scrameta/mega_videl/README.md

# mega_videl

- 1GB 32-bit wide DDR3 ram running at 400MHz
- Cyclone V GX FPGA
- DVI + audio output up to 300MHz (4K30)
- Falcon audio intercept + modify
- High speed link to future expansion (Plan: System ram board)
- PCIe 1x
- USB2
- Ethernet
