scrameta/mega_videl/board/kicad/mega_videl/mega_videl.kicad_pcb

## KiCad design board/kicad/mega_videl/mega_videl.kicad_pcb (2026-10-27)

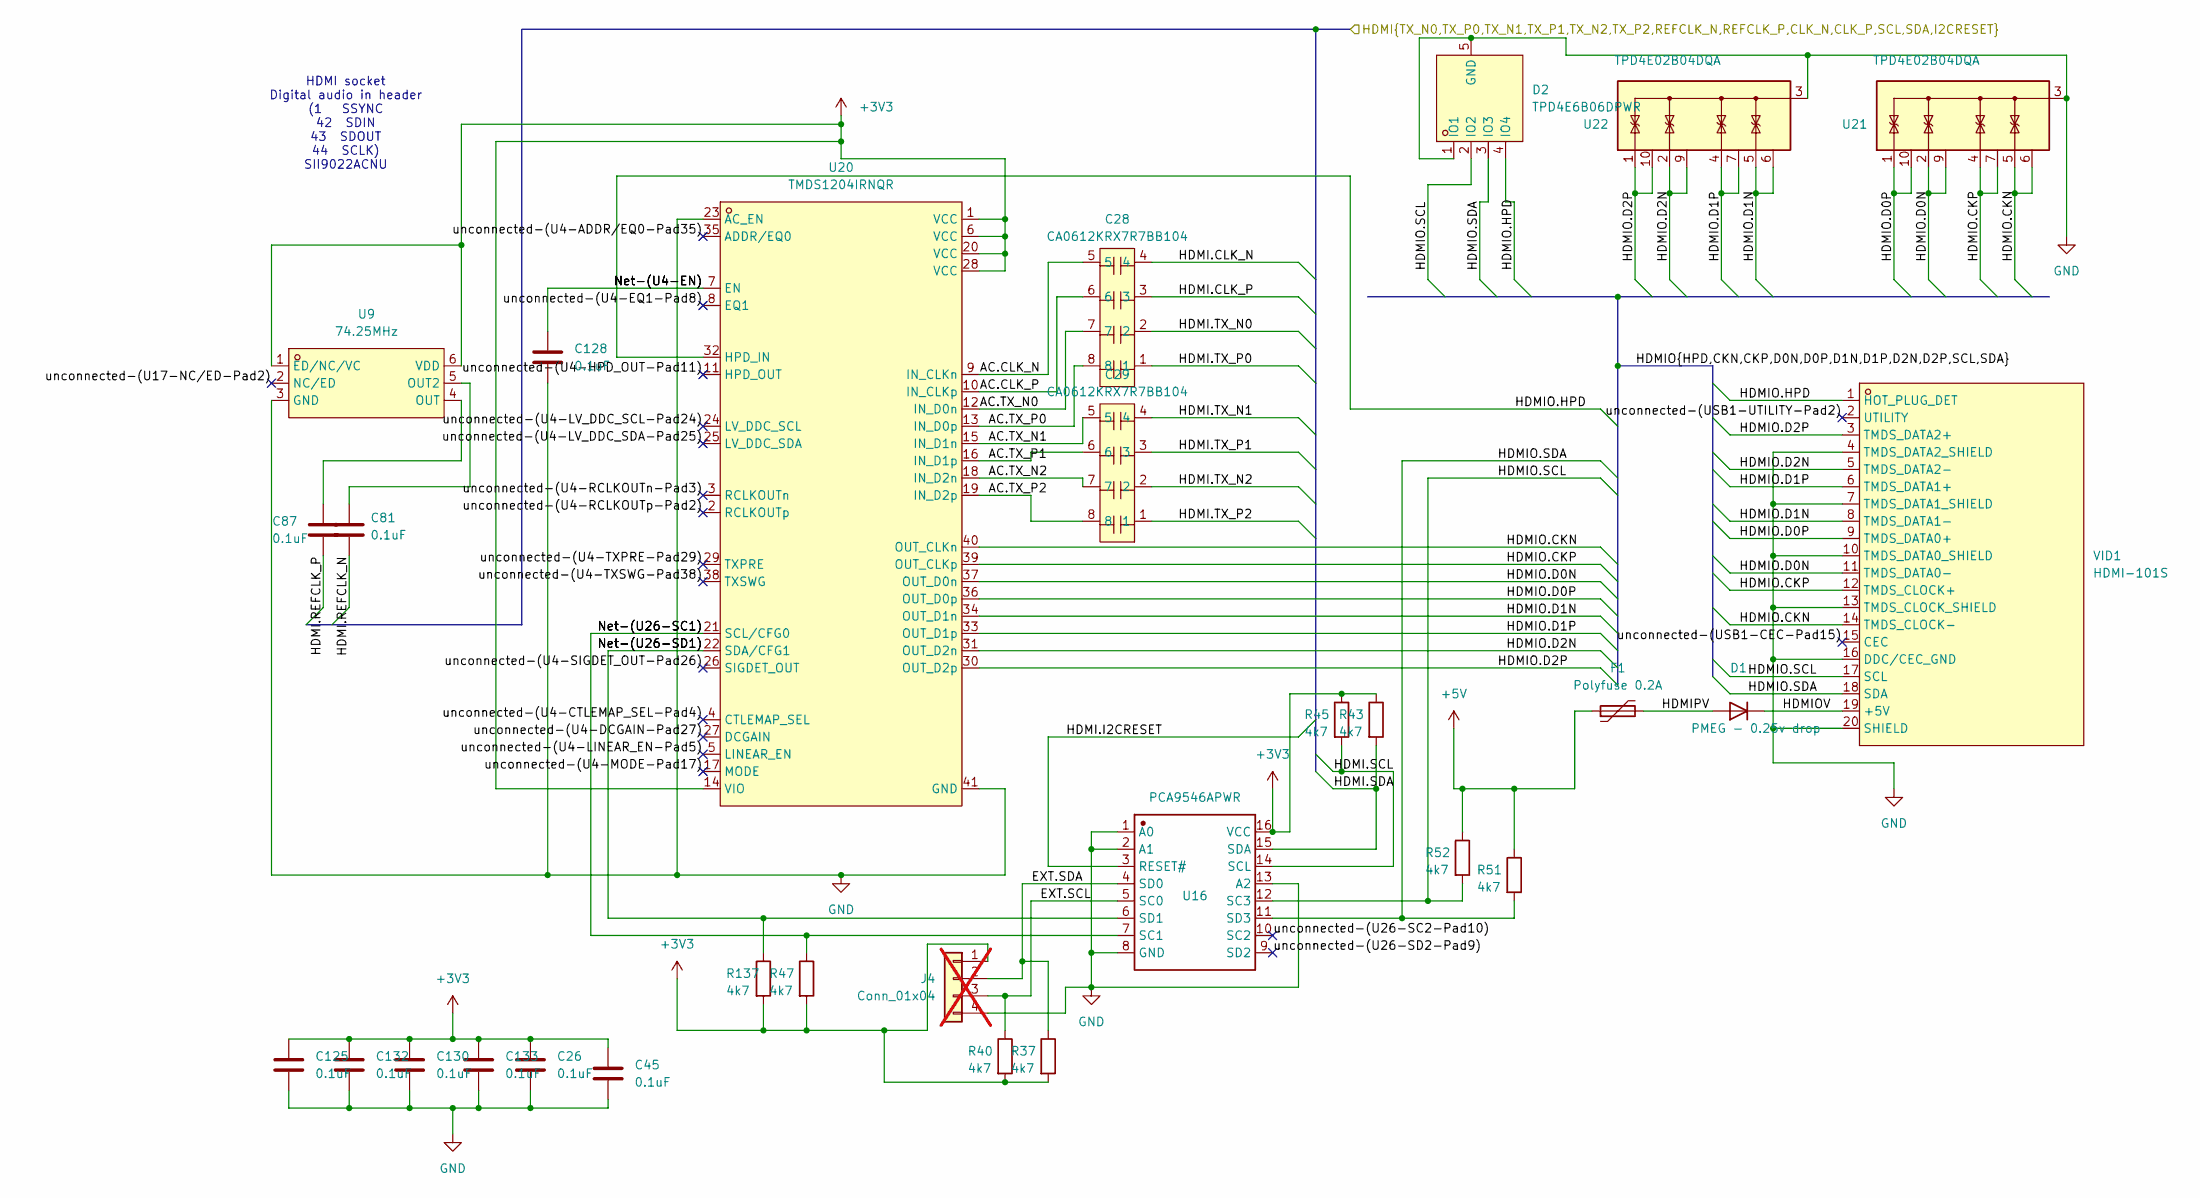
[picture p1: schematic video.kicad_sch]

Parts:
C26, C45, C125, C132: 0.1uF; C_0603_1608Metric; LCSC C14663
C28, C29: CA0612KRX7R7BB104; CAP-ARRAY-SMD_0612-8P-L3.2-W1.6-BL; MPN CA0612KRX7R7BB104; LCSC Part C576639
C81, C87, C128, C130, C133: 0.1uF; C_0402_1005Metric; LCSC C1525
D1: PMEG - 0.25v drop; D_SOD-323; LCSC C7420331
D2: TPD4E6B06DPWR; X2SON-4_L0.8-W0.8-P0.48-TL-A; MPN TPD4E6B06DPWR; LCSC Part C2869397
F1: Polyfuse 0.2A; R_0603_1608Metric; LCSC C207011
J4: Conn_01x04; PinHeader_1x04_P2.54mm_Vertical; not fitted
R37, R40, R43, R45, R47, R51, R52, R137: 4k7; R_0603_1608Metric; LCSC C23162
U9: 74.25MHz; OSC-SMD_6P-L3.2-W2.5-BL_RENESAS_XLH3XXXXXXXXXX; MPN SiT9121AC-2B2-33E74.250000; LCSC Part C836732
U16: PCA9546APWR; TSSOP-16_L5.0-W4.4-P0.65-LS6.4-BL; Manufacturer Part PCA9546APWR; JLC_3DModel 534f03d8fe164fbab551f91e5a792e30
U20: TMDS1204IRNQR; WQFN-40_L6.0-W4.0-P0.40-TL-EP4.7; MPN TMDS1204IRNQR; LCSC Part C19272424
U21, U22: TPD4E02B04DQA; USON-10_2.5x1.0mm_P0.5mm; LCSC C106794
VID1: HDMI-101S; HDMI-SMD_HDMI-101S; MPN HDMI-101S; LCSC Part C720620

Connections:
+3V3: C26.1, C45.1, C125.1, C130.1, C132.1, C133.1, J4.1, R37.2, R40.2, R43.1, R45.1, R47.2, R137.2, U9.1 (ED/NC/VC), U9.6 (VDD), U16.16 (VCC), U20.1 (VCC), U20.6 (VCC), U20.14 (VIO), U20.20 (VCC), U20.28 (VCC); also elsewhere on the board
+5V: F1.1, R51.1, R52.1; also elsewhere on the board
/fpga/HDMI.CLK_N: C28.4; also elsewhere on the board
/fpga/HDMI.CLK_P: C28.3; also elsewhere on the board
/fpga/HDMI.I2CRESET: U16.3 (RESET#); also elsewhere on the board
/fpga/HDMI.REFCLK_N: C81.1; also elsewhere on the board
/fpga/HDMI.REFCLK_P: C87.1; also elsewhere on the board
/fpga/HDMI.SCL: R45.2, U16.14 (SCL); also elsewhere on the board
/fpga/HDMI.SDA: R43.2, U16.15 (SDA); also elsewhere on the board
/fpga/HDMI.TX_N0: C28.2; also elsewhere on the board
/fpga/HDMI.TX_N1: C29.4; also elsewhere on the board
/fpga/HDMI.TX_N2: C29.2; also elsewhere on the board
/fpga/HDMI.TX_P0: C28.1; also elsewhere on the board
/fpga/HDMI.TX_P1: C29.3; also elsewhere on the board
/fpga/HDMI.TX_P2: C29.1; also elsewhere on the board
/video/AC.CLK_N: C28.5, U20.9 (IN_CLKn)
/video/AC.CLK_P: C28.6, U20.10 (IN_CLKp)
/video/AC.TX_N0: C28.7, U20.12 (IN_D0n)
/video/AC.TX_N1: C29.5, U20.15 (IN_D1n)
/video/AC.TX_N2: C29.7, U20.18 (IN_D2n)
/video/AC.TX_P0: C28.8, U20.13 (IN_D0p)
/video/AC.TX_P1: C29.6, U20.16 (IN_D1p)
/video/AC.TX_P2: C29.8, U20.19 (IN_D2p)
/video/EXT.SCL: J4.3, R40.1, U16.5 (SC0)
/video/EXT.SDA: J4.2, R37.1, U16.4 (SD0)
/video/HDMIO.CKN: U20.40 (OUT_CLKn), U21.5 (IO4), U21.6 (NC), VID1.14 (TMDS_CLOCK-)
/video/HDMIO.CKP: U20.39 (OUT_CLKp), U21.4 (IO3), U21.7 (NC), VID1.12 (TMDS_CLOCK+)
/video/HDMIO.D0N: U20.37 (OUT_D0n), U21.2 (IO2), U21.9 (NC), VID1.11 (TMDS_DATA0-)
/video/HDMIO.D0P: U20.36 (OUT_D0p), U21.1 (IO1), U21.10 (NC), VID1.9 (TMDS_DATA0+)
/video/HDMIO.D1N: U20.34 (OUT_D1n), U22.5 (IO4), U22.6 (NC), VID1.8 (TMDS_DATA1-)
/video/HDMIO.D1P: U20.33 (OUT_D1p), U22.4 (IO3), U22.7 (NC), VID1.6 (TMDS_DATA1+)
/video/HDMIO.D2N: U20.31 (OUT_D2n), U22.2 (IO2), U22.9 (NC), VID1.5 (TMDS_DATA2-)
/video/HDMIO.D2P: U20.30 (OUT_D2p), U22.1 (IO1), U22.10 (NC), VID1.3 (TMDS_DATA2+)
/video/HDMIO.HPD: D2.4 (IO4), U20.32 (HPD_IN), VID1.1 (HOT_PLUG_DET)
/video/HDMIO.SCL: D2.2 (IO2), R52.2, U16.12 (SC3), VID1.17 (SCL)
/video/HDMIO.SDA: D2.3 (IO3), R51.2, U16.11 (SD3), VID1.18 (SDA)
/video/HDMIOV: D1.1 (K), VID1.19 (+5V)
/video/HDMIPV: D1.2 (A), F1.2
/video/Net-(U4-EN): C128.1, U20.7 (EN)
/video/Net-(U26-SC1): R47.1, U16.7 (SC1), U20.21 (SCL/CFG0)
/video/Net-(U26-SD1): R137.1, U16.6 (SD1), U20.22 (SDA/CFG1)
/video/unconnected-(U4-ADDR/EQ0-Pad35): U20.35 (ADDR/EQ0)
/video/unconnected-(U4-CTLEMAP_SEL-Pad4): U20.4 (CTLEMAP_SEL)
/video/unconnected-(U4-DCGAIN-Pad27): U20.27 (DCGAIN)
/video/unconnected-(U4-EQ1-Pad8): U20.8 (EQ1)
/video/unconnected-(U4-HPD_OUT-Pad11): U20.11 (HPD_OUT)
/video/unconnected-(U4-LINEAR_EN-Pad5): U20.5 (LINEAR_EN)
/video/unconnected-(U4-LV_DDC_SCL-Pad24): U20.24 (LV_DDC_SCL)
/video/unconnected-(U4-LV_DDC_SDA-Pad25): U20.25 (LV_DDC_SDA)
/video/unconnected-(U4-MODE-Pad17): U20.17 (MODE)
/video/unconnected-(U4-RCLKOUTn-Pad3): U20.3 (RCLKOUTn)
/video/unconnected-(U4-RCLKOUTp-Pad2): U20.2 (RCLKOUTp)
/video/unconnected-(U4-SIGDET_OUT-Pad26): U20.26 (SIGDET_OUT)
/video/unconnected-(U4-TXPRE-Pad29): U20.29 (TXPRE)
/video/unconnected-(U4-TXSWG-Pad38): U20.38 (TXSWG)
/video/unconnected-(U17-NC/ED-Pad2): U9.2 (NC/ED)
/video/unconnected-(U26-SC2-Pad10): U16.10 (SC2)
/video/unconnected-(U26-SD2-Pad9): U16.9 (SD2)
/video/unconnected-(USB1-CEC-Pad15): VID1.15 (CEC)
/video/unconnected-(USB1-UTILITY-Pad2): VID1.2 (UTILITY)
GND: C26.2, C45.2, C125.2, C128.2, C130.2, C132.2, C133.2, D2.1 (IO1), D2.5 (GND), J4.4, U9.3 (GND), U16.1 (A0), U16.2 (A1), U16.8 (GND), U16.13 (A2), U20.23 (AC_EN), U20.41 (GND), U21.3 (G), U21.8 (G), U22.3 (G), U22.8 (G), VID1.4 (TMDS_DATA2_SHIELD), VID1.7 (TMDS_DATA1_SHIELD), VID1.10 (TMDS_DATA0_SHIELD), VID1.13 (TMDS_CLOCK_SHIELD), VID1.16 (DDC/CEC_GND), VID1.20 (SHIELD); also elsewhere on the board
unnamed: C81.2, U9.5 (OUT2)
unnamed: C87.2, U9.4 (OUT)

Notes on the sheet:
HDMI socket Digital audio in header (1 SSYNC 42 SDIN 43 SDOUT 44 SCLK) SII9022ACNU

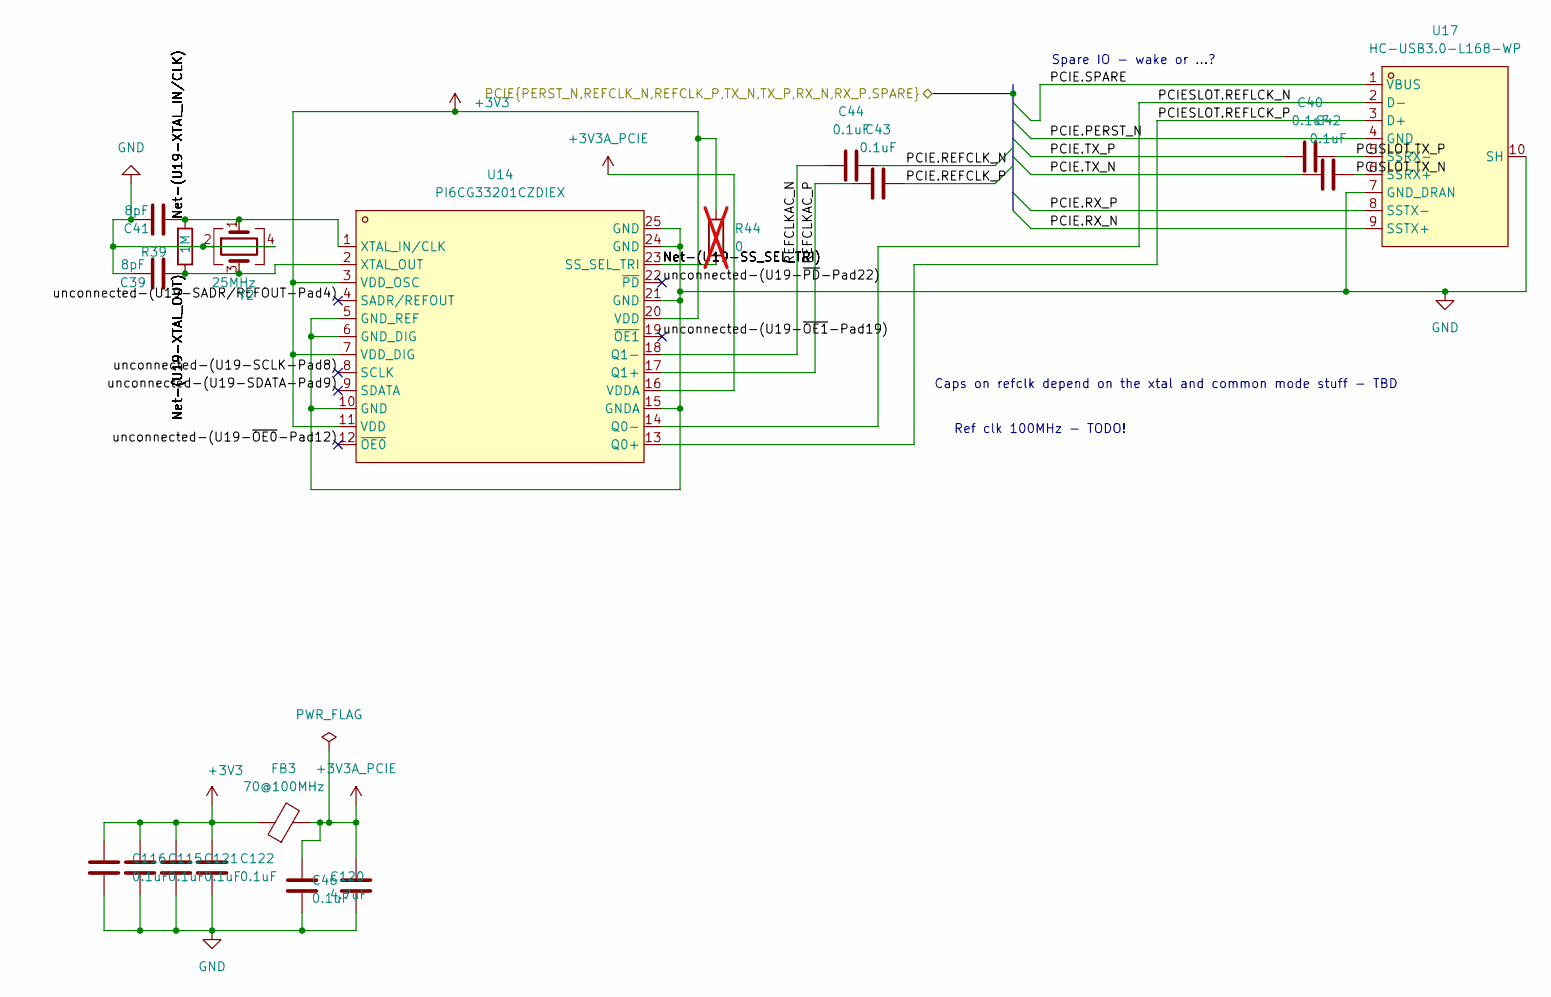
[picture p2: schematic PCIe.kicad_sch]

Parts:
C39, C41: 8pF; C_0603_1608Metric; LCSC C327316
C40, C42, C43, C44: 0.1uF; C_0603_1608Metric; LCSC C14663
C46, C115, C116, C121, C122: 0.1uF; C_0402_1005Metric; LCSC C1525
C120: 4.7uF; C_0805_2012Metric; LCSC C1779
FB3: 70@100MHz; L_0805_2012Metric; LCSC C85840
R39: 1M; R_0603_1608Metric; LCSC C22935
R44: 0; R_0603_1608Metric; LCSC C21189; not fitted
U14: PI6CG33201CZDIEX; TQFN-24_L4.0-W4.0-P0.50-TL-EP2.8; MPN PI6CG33201CZDIEX; LCSC Part C1236517
U17: HC-USB3.0-L168-WP; USB-TH_USB3.0-A; MPN HC-USB3.0-L168-WP; LCSC Part C7501850
Y2: 25MHz; Crystal_SMD_3225-4Pin_3.2x2.5mm; LCSC C5742221

Connections:
+3V3: C115.1, C116.1, C121.1, C122.1, FB3.1, R44.1, U14.3 (VDD_OSC), U14.7 (VDD_DIG), U14.11 (VDD), U14.20 (VDD); also elsewhere on the board
+3V3A_PCIE: C46.1, C120.1, FB3.2, U14.16 (VDDA)
/PCIe/Net-(U19-SS_SEL_TRI): R44.2, U14.23 (SS_SEL_TRI)
/PCIe/Net-(U19-XTAL_IN/CLK): C41.2, R39.2, U14.1 (XTAL_IN/CLK), Y2.1
/PCIe/Net-(U19-XTAL_OUT): C39.2, R39.1, U14.2 (XTAL_OUT), Y2.3
/PCIe/PCIESLOT.REFLCK_N: U14.14 (Q0-), U17.2 (D-)
/PCIe/PCIESLOT.REFLCK_P: U14.13 (Q0+), U17.3 (D+)
/PCIe/PCISLOT.TX_N: C42.2, U17.6 (SSRX+)
/PCIe/PCISLOT.TX_P: C40.2, U17.5 (SSRX-)
/PCIe/REFCLKAC_N: C44.1, U14.18 (Q1-)
/PCIe/REFCLKAC_P: C43.1, U14.17 (Q1+)
/PCIe/unconnected-(U19-SADR/REFOUT-Pad4): U14.4 (SADR/REFOUT)
/PCIe/unconnected-(U19-SCLK-Pad8): U14.8 (SCLK)
/PCIe/unconnected-(U19-SDATA-Pad9): U14.9 (SDATA)
/PCIe/unconnected-(U19-~OE0-Pad12): U14.12 (~OE0)
/PCIe/unconnected-(U19-~OE1-Pad19): U14.19 (~OE1)
/PCIe/unconnected-(U19-~PD-Pad22): U14.22 (~PD)
/fpga/PCIE.PERST_N: U17.4 (GND); also elsewhere on the board
/fpga/PCIE.REFCLK_N: C44.2; also elsewhere on the board
/fpga/PCIE.REFCLK_P: C43.2; also elsewhere on the board
/fpga/PCIE.RX_N: U17.9 (SSTX+); also elsewhere on the board
/fpga/PCIE.RX_P: U17.8 (SSTX-); also elsewhere on the board
/fpga/PCIE.SPARE: U17.1 (VBUS); also elsewhere on the board
/fpga/PCIE.TX_N: C42.1; also elsewhere on the board
/fpga/PCIE.TX_P: C40.1; also elsewhere on the board
GND: C39.1, C41.1, C46.2, C115.2, C116.2, C120.2, C121.2, C122.2, U14.5 (GND_REF), U14.6 (GND_DIG), U14.10 (GND), U14.15 (GNDA), U14.21 (GND), U14.24 (GND), U14.25 (GND), U17.7 (GND_DRAN), U17.10 (SH), Y2.2, Y2.4; also elsewhere on the board

Notes on the sheet:
Caps on refclk depend on the xtal and common mode stuff - TBD
Spare IO - wake or ...?
Ref clk 100MHz - TODO!
