scrameta/mega_videl/board/kicad/mega_videl/mega_videl.kicad_pcb

## KiCad design board/kicad/mega_videl/mega_videl.kicad_pcb (continued)

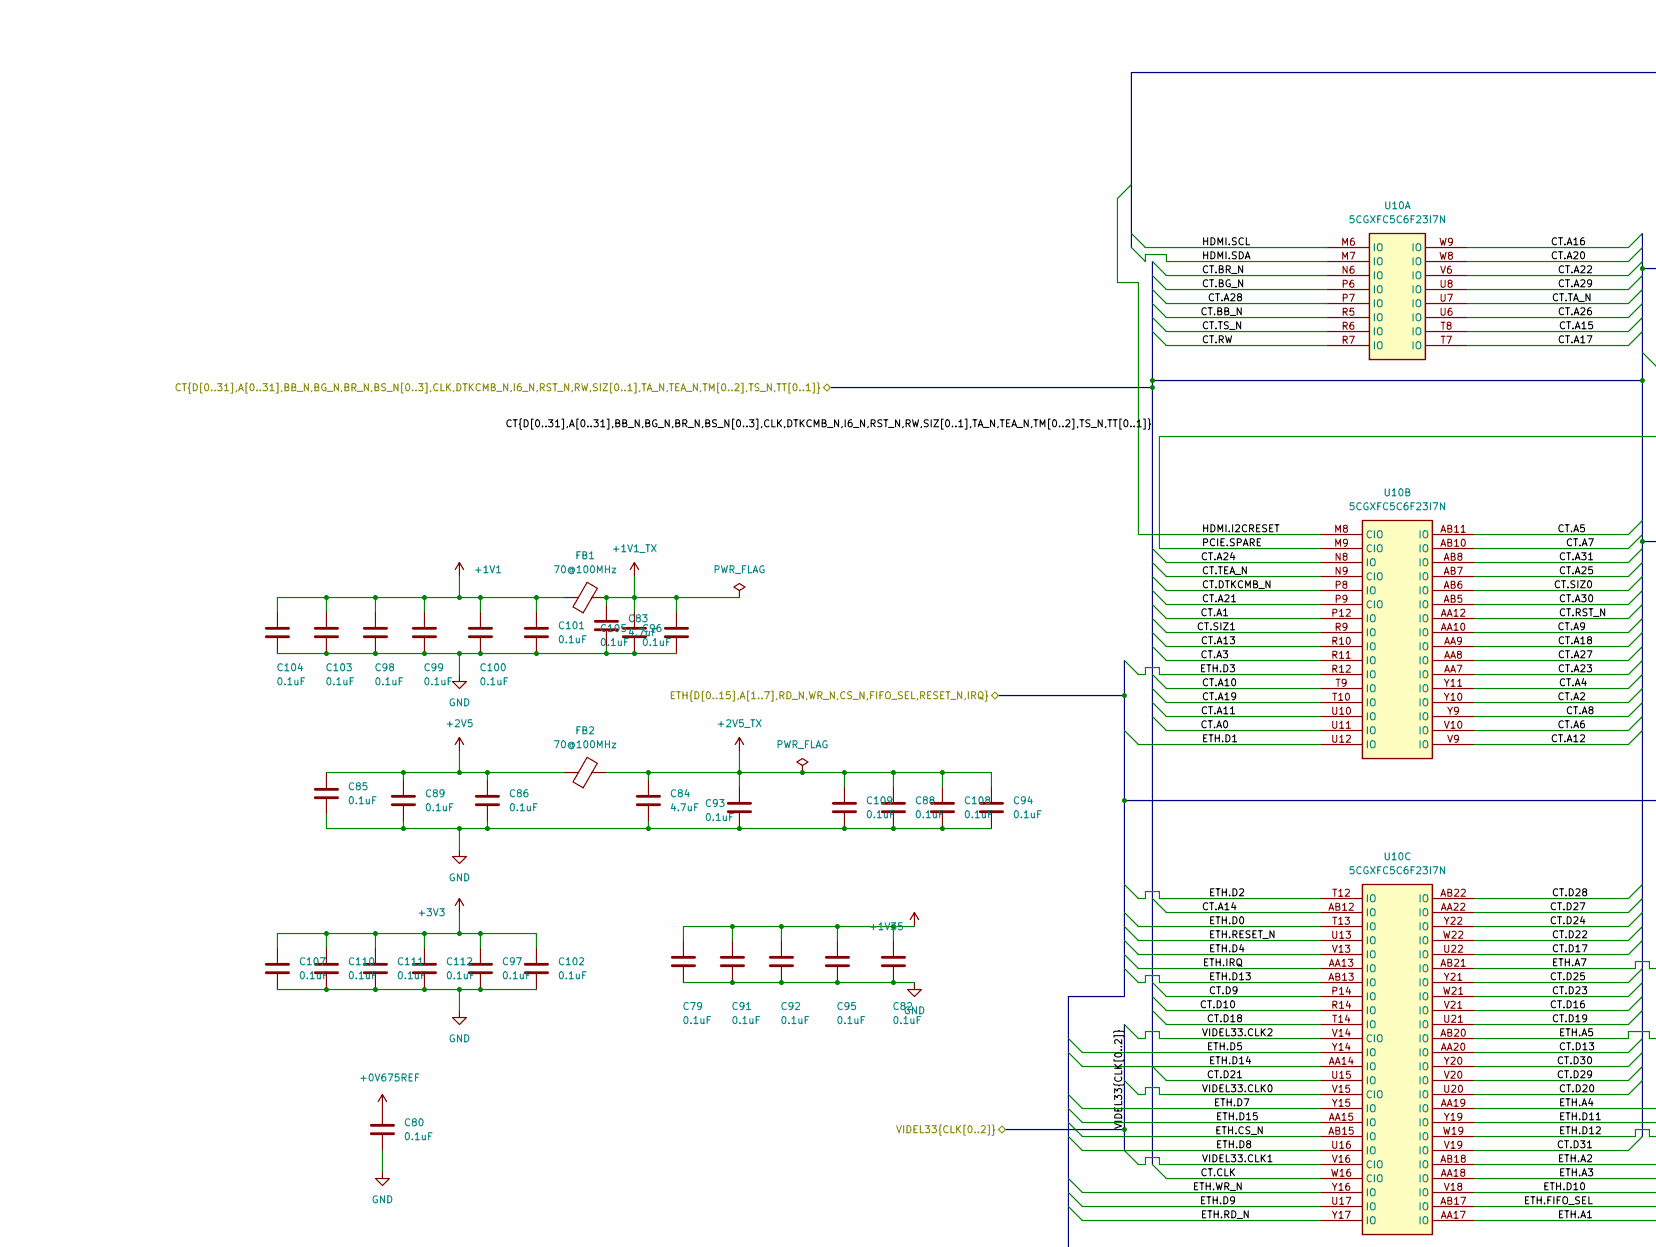
[picture p3: schematic fpga.kicad_sch, part in row 1, column 1]

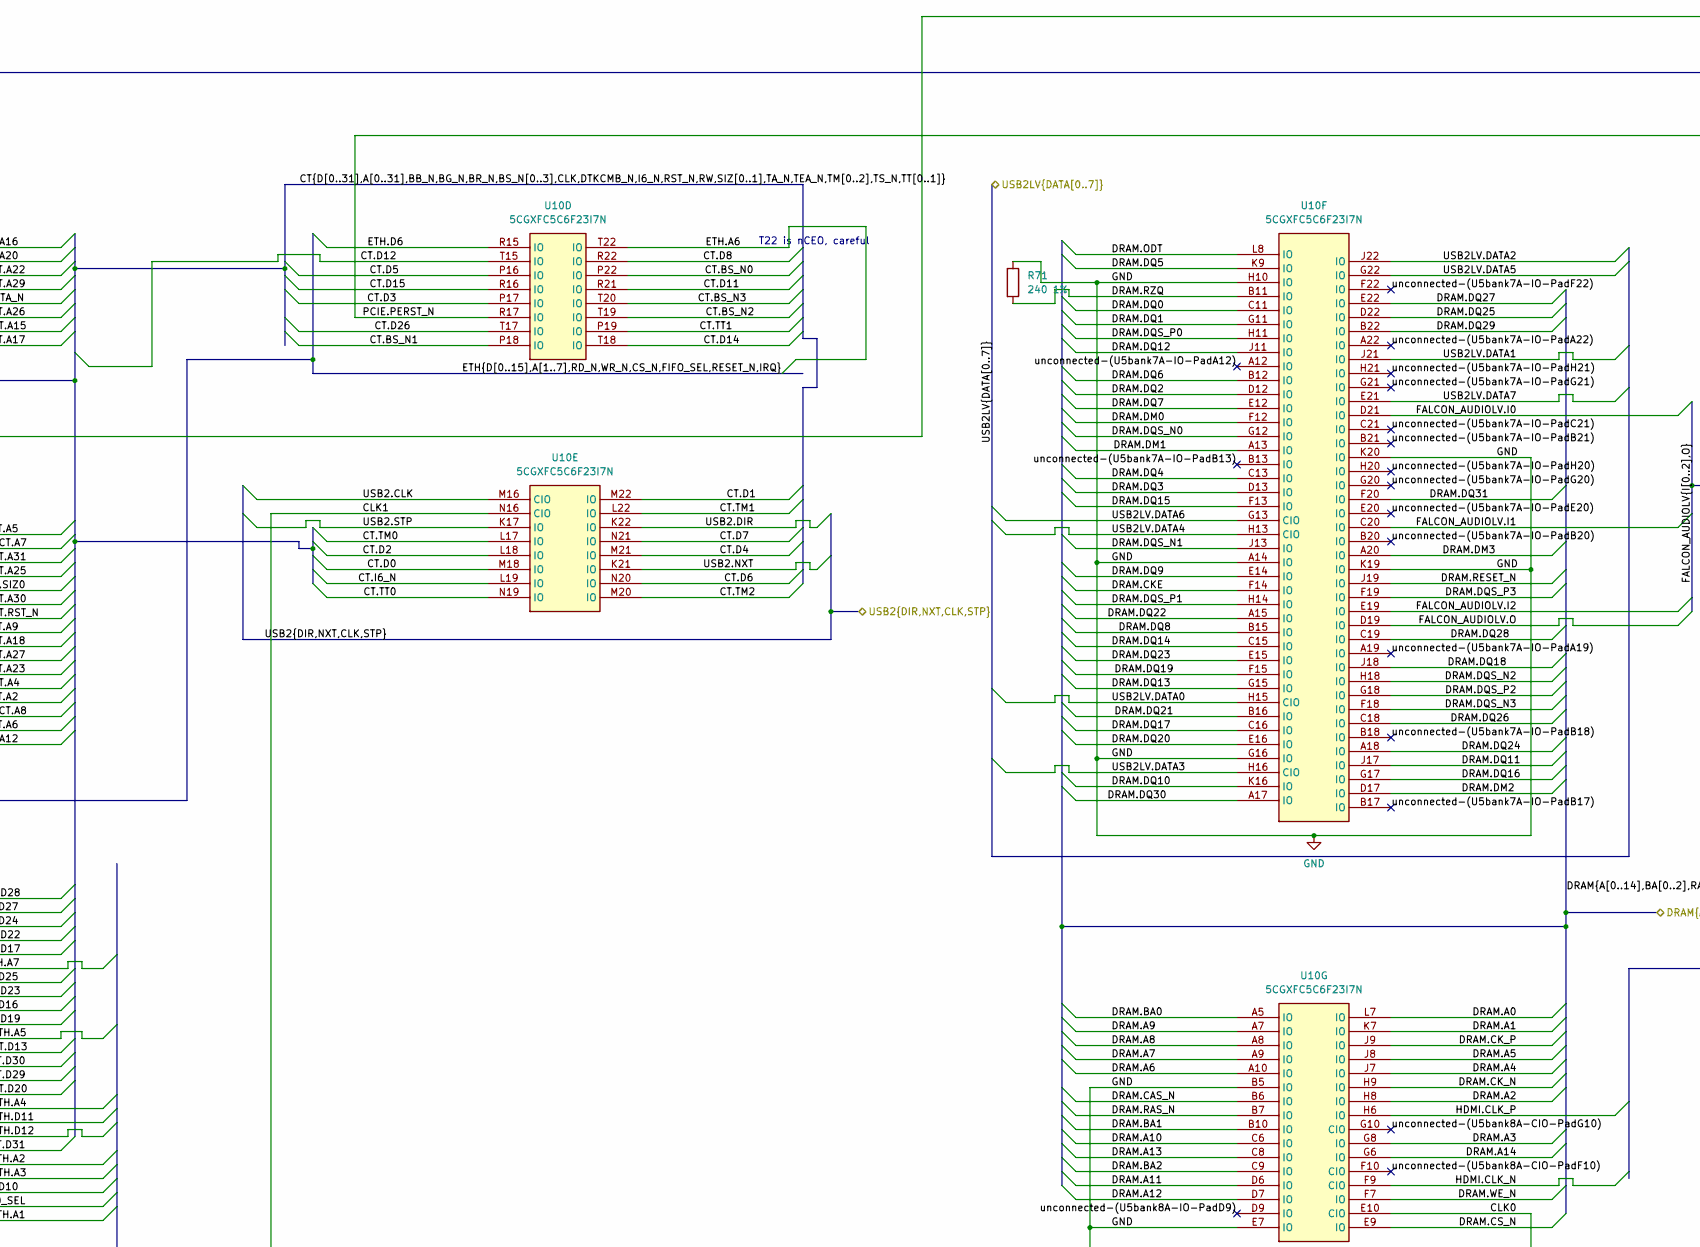
[picture p4: schematic fpga.kicad_sch, part in row 1, column 2]

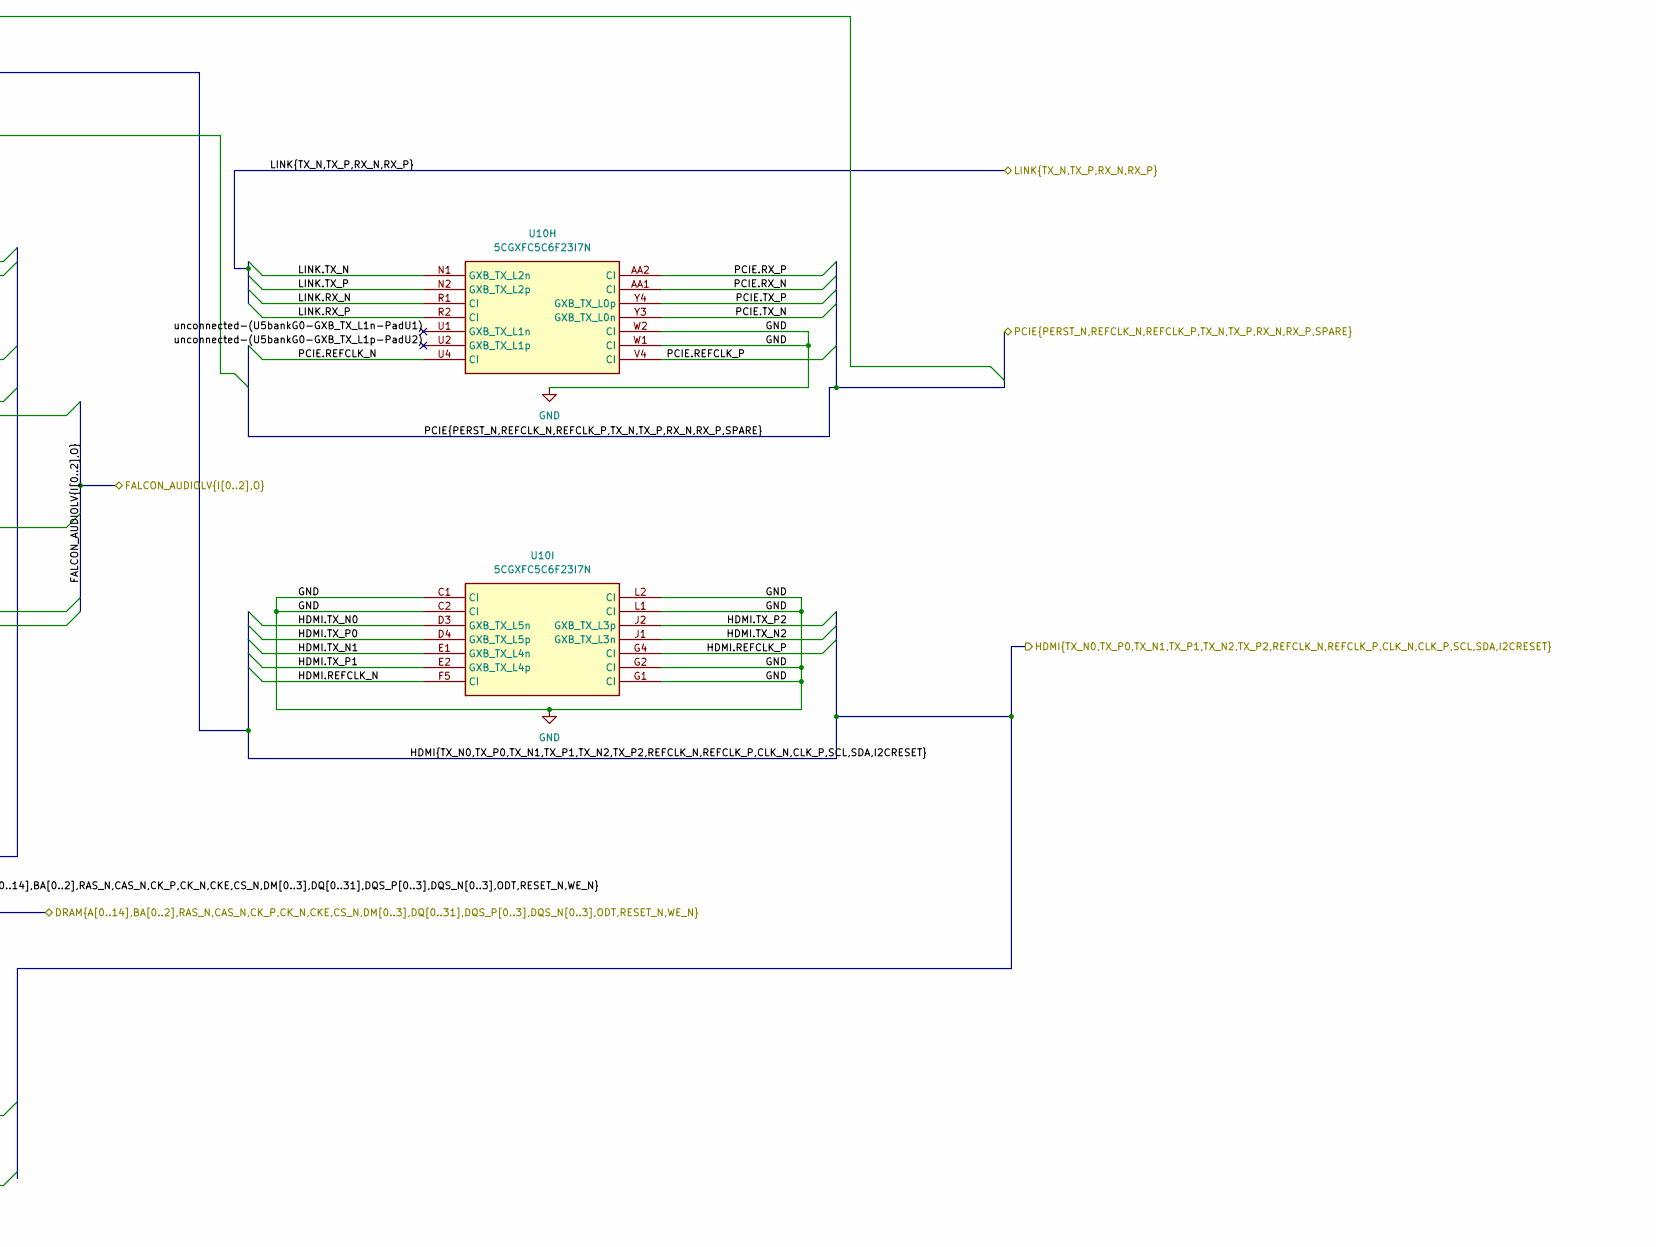
[picture p5: schematic fpga.kicad_sch, part in row 1, column 3]

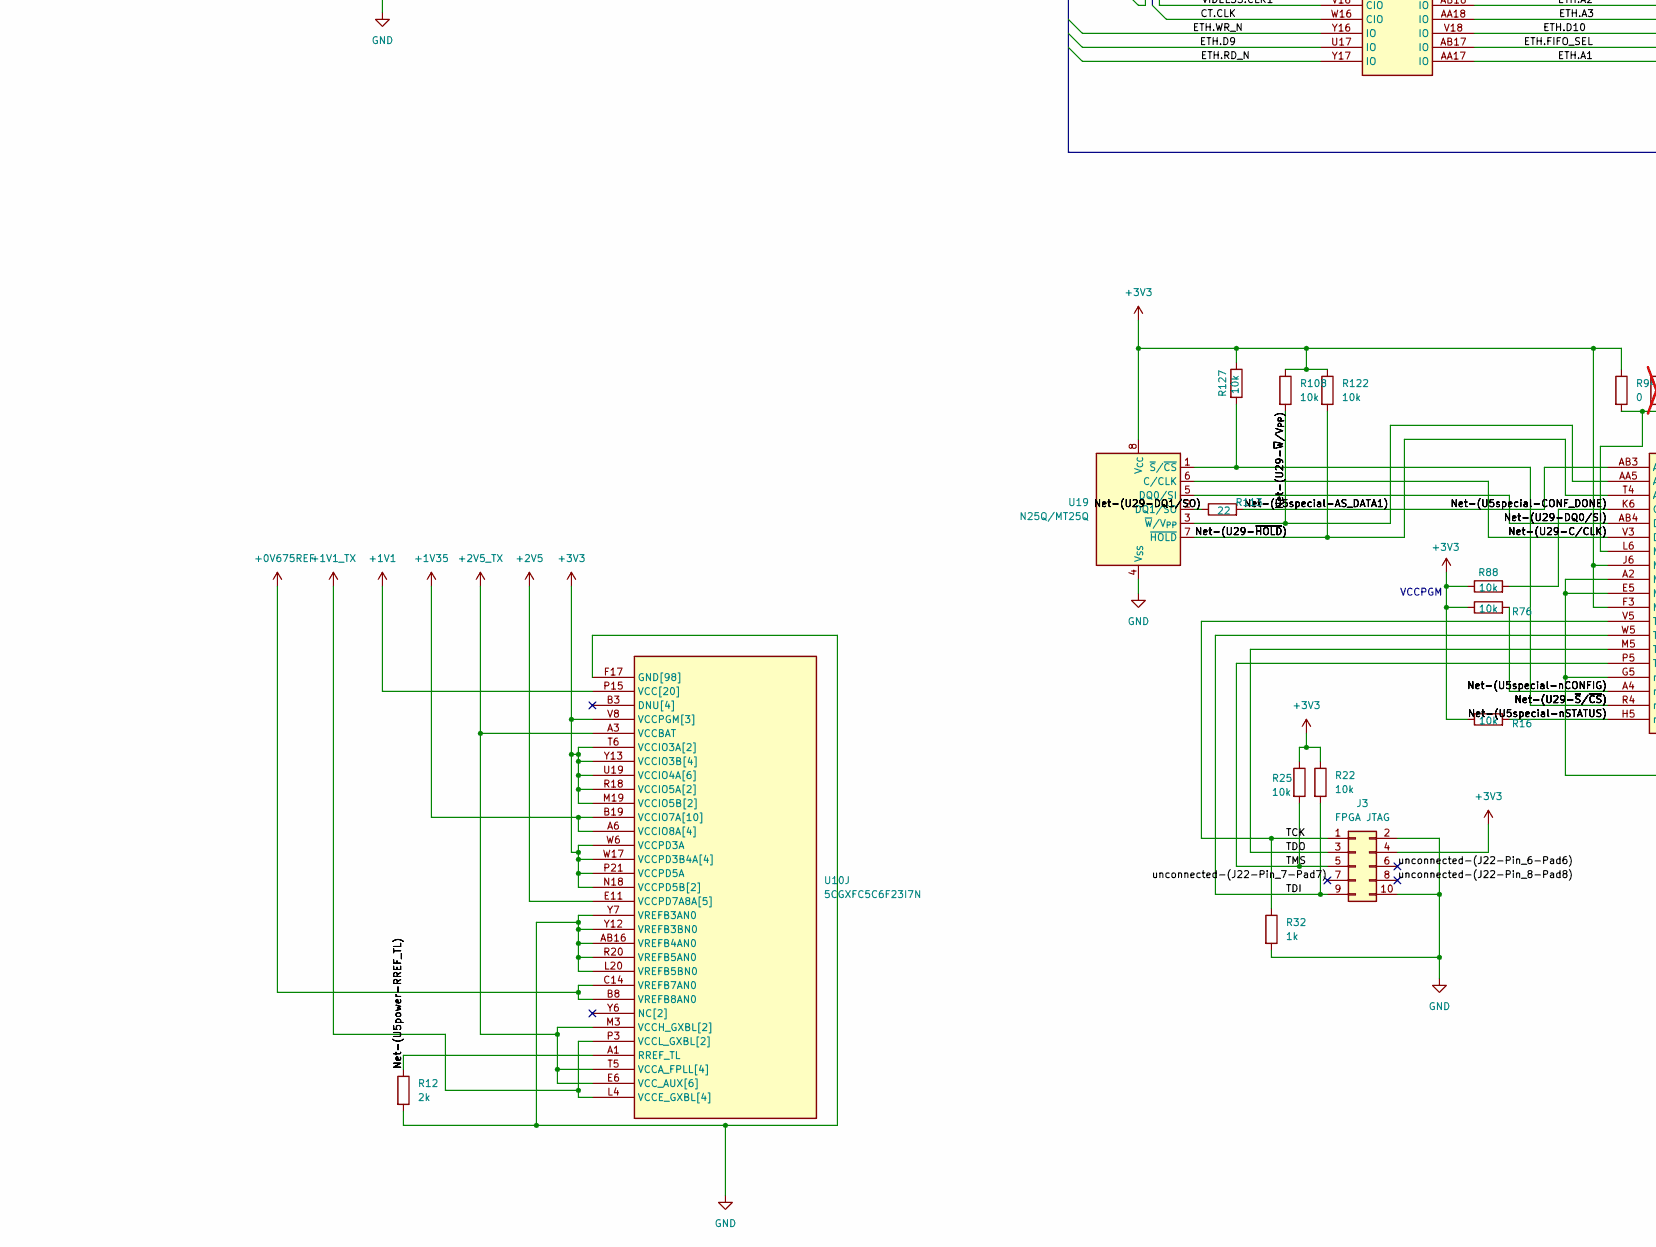
[picture p6: schematic fpga.kicad_sch, part in row 2, column 1]

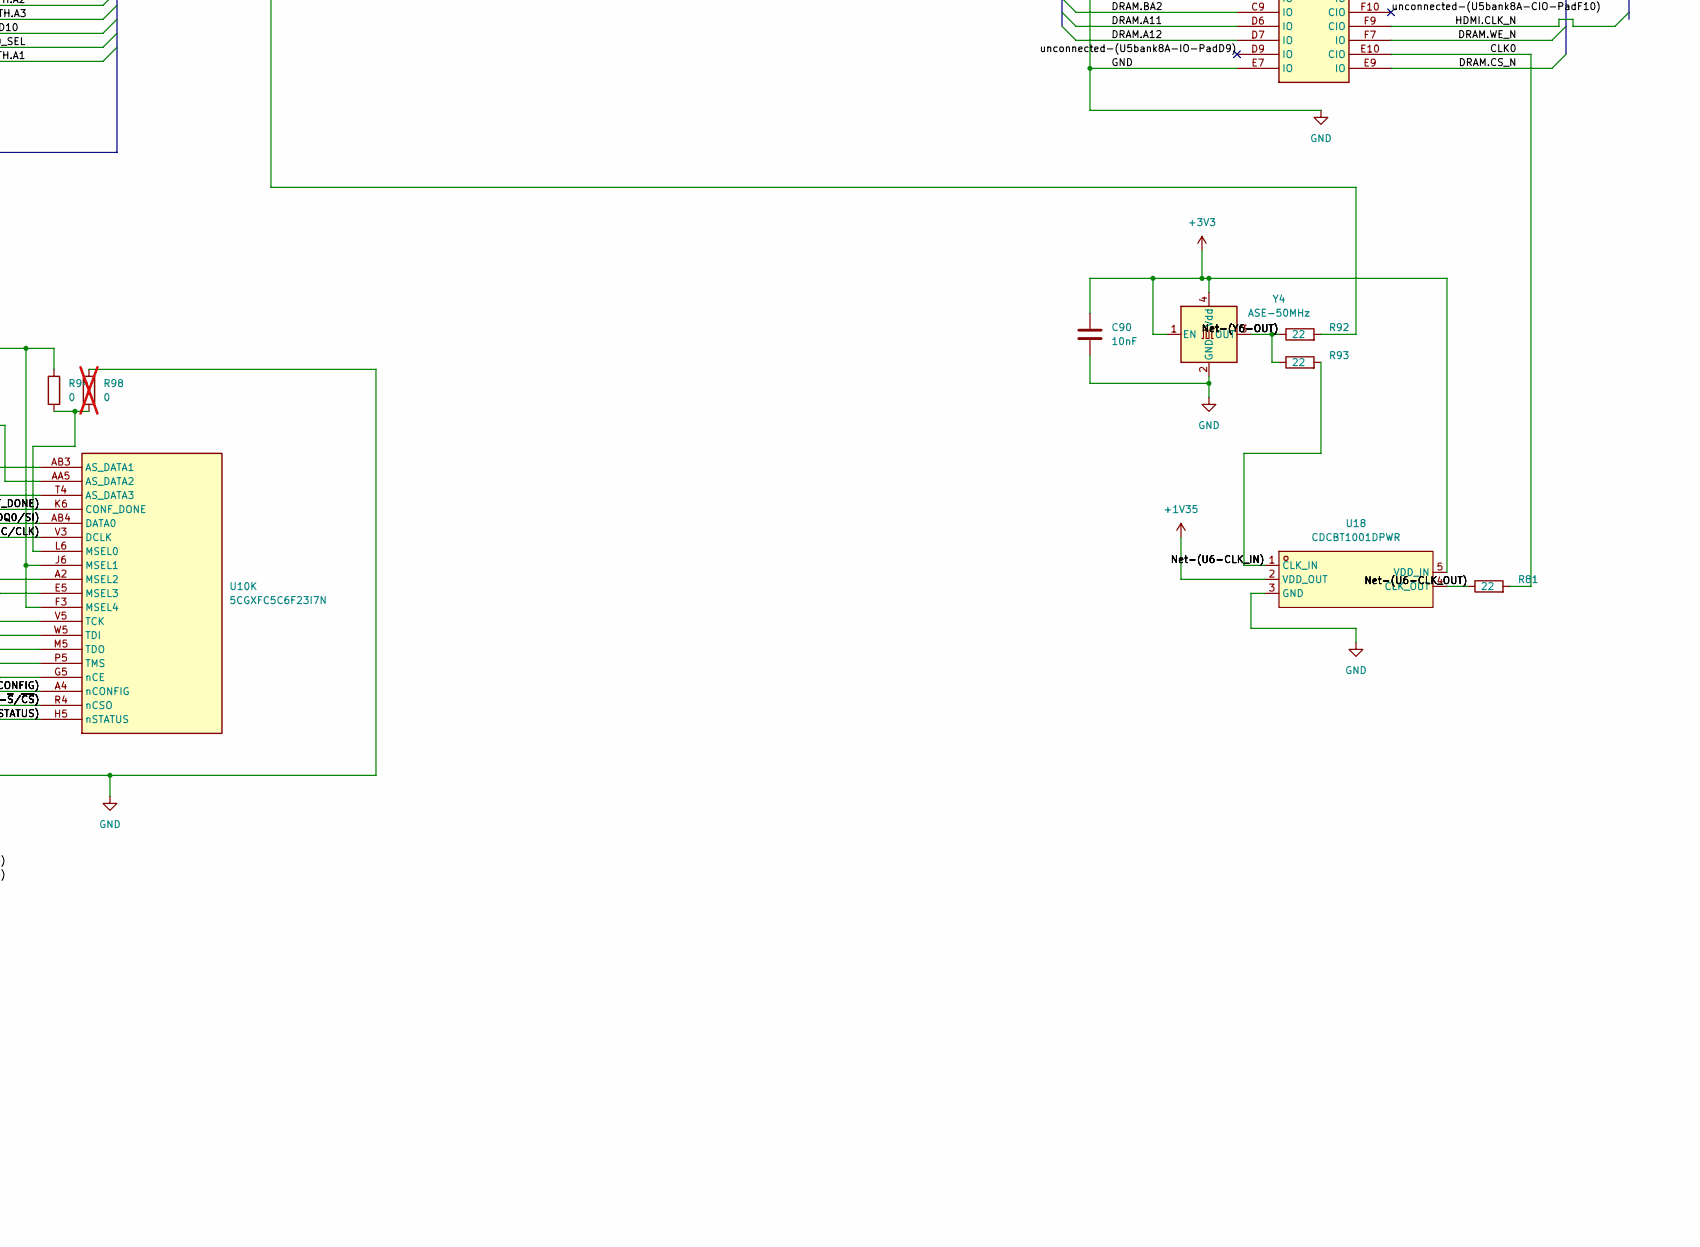
[picture p7: schematic fpga.kicad_sch, part in row 2, column 2]

Parts:
C79, C80, C82, C85, C86, C88, C89, C91, C92, C93, C94, C95, C96, C97, C98, C99, C100, C101, C102, C103, C104, C105, C107, C108, C109, C110, C111, C112: 0.1uF; C_0402_1005Metric; LCSC C1525
C83, C84: 4.7uF; C_0805_2012Metric; LCSC C1779
C90: 10nF; C_0402_1005Metric; LCSC C15195
FB1, FB2: 70@100MHz; L_0805_2012Metric; LCSC C85840
J3: FPGA JTAG; IDC-Header_2x05_P2.54mm_Vertical_SMD; LCSC C17323676
R12: 2k; R_0603_1608Metric; LCSC C22975
R16, R22, R25, R76, R88, R108, R122, R127: 10k; R_0603_1608Metric; LCSC C25804
R32: 1k; R_0603_1608Metric; LCSC C21190
R71: 240 1%; R_0603_1608Metric; LCSC C23350
R81, R92, R93, R113: 22; R_0603_1608Metric; LCSC C23345
R94: 0; R_0402_1005Metric; LCSC C17168
R98: 0; R_0402_1005Metric; LCSC C17168; not fitted
U10: 5CGXFC5C6F23I7N; FBGA-484_L23.0-W23.0-R22-C22-P1.00-TL; LCSC Part C1550726
U18: CDCBT1001DPWR; X2SON-5_L0.8-W0.8-P0.48-BR; MPN CDCBT1001DPWR; LCSC Part C5215096
U19: N25Q/MT25Q; SOIC-8_5.3x6.2mm_P1.27mm; LCSC C2802705
Y4: ASE-50MHz; Oscillator_SMD_Abracon_ASE-4Pin_3.2x2.5mm; LCSC C5203552

Connections:
+0V675REF: C80.1, U10.B8 (VREFB8AN0), U10.C14 (VREFB7AN0); also elsewhere on the board
+1V1: C98.1, C99.1, C100.1, C101.1, C103.1, C104.1, FB1.1, U10.J10 (VCC[20]), U10.J12 (VCC[20]), U10.J14 (VCC[20]), U10.J16 (VCC[20]), U10.K11 (VCC[20]), U10.K13 (VCC[20]), U10.K15 (VCC[20]), U10.L10 (VCC[20]), U10.L12 (VCC[20]), U10.L14 (VCC[20]), U10.L16 (VCC[20]), U10.M11 (VCC[20]), U10.M13 (VCC[20]), U10.M15 (VCC[20]), U10.N10 (VCC[20]), U10.N12 (VCC[20]), U10.N14 (VCC[20]), U10.P11 (VCC[20]), U10.P13 (VCC[20]), U10.P15 (VCC[20]); also elsewhere on the board
+1V1_TX: C83.1, C96.1, C105.1, FB1.2, U10.J4 (VCCE_GXBL[4]), U10.K3 (VCCL_GXBL[2]), U10.K5 (VCCE_GXBL[4]), U10.L4 (VCCE_GXBL[4]), U10.N4 (VCCE_GXBL[4]), U10.P3 (VCCL_GXBL[2])
+1V35: C79.1, C82.1, C91.1, C92.1, C95.1, U10.A6 (VCCIO8A[4]), U10.A16 (VCCIO7A[10]), U10.B19 (VCCIO7A[10]), U10.C7 (VCCIO8A[4]), U10.C12 (VCCIO7A[10]), U10.C22 (VCCIO7A[10]), U10.D15 (VCCIO7A[10]), U10.E8 (VCCIO8A[4]), U10.E18 (VCCIO7A[10]), U10.F11 (VCCIO7A[10]), U10.F21 (VCCIO7A[10]), U10.G7 (VCCIO8A[4]), U10.G14 (VCCIO7A[10]), U10.H17 (VCCIO7A[10]), U18.2 (VDD_OUT); also elsewhere on the board
+2V5: C85.1, C86.1, C89.1, FB2.1, U10.C10 (VCCPD7A8A[5]), U10.D8 (VCCPD7A8A[5]), U10.D14 (VCCPD7A8A[5]), U10.D16 (VCCPD7A8A[5]), U10.E11 (VCCPD7A8A[5]); also elsewhere on the board
+2V5_TX: C84.1, C88.1, C93.1, C94.1, C108.1, C109.1, FB2.2, U10.A3 (VCCBAT), U10.D11 (VCC_AUX[6]), U10.D18 (VCC_AUX[6]), U10.E6 (VCC_AUX[6]), U10.F4 (VCCA_FPLL[4]), U10.H19 (VCCA_FPLL[4]), U10.M3 (VCCH_GXBL[2]), U10.T3 (VCCH_GXBL[2]), U10.T5 (VCCA_FPLL[4]), U10.U18 (VCCA_FPLL[4]), U10.W7 (VCC_AUX[6]), U10.W13 (VCC_AUX[6]), U10.W18 (VCC_AUX[6])
+3V3: C90.2, C97.1, C102.1, C107.1, C110.1, C111.1, C112.1, J3.4, R16.1, R22.1, R25.1, R76.1, R88.1, R94.1, R108.1, R122.1, R127.1, U10.AA16 (VCCIO4A[6]), U10.AA21 (VCCIO4A[6]), U10.F3 (MSEL4), U10.F8 (VCCPGM[3]), U10.J6 (MSEL1), U10.K18 (VCCIO5B[2]), U10.M17 (VCCPD5B[2]), U10.M19 (VCCIO5B[2]), U10.N18 (VCCPD5B[2]), U10.P20 (VCCIO5A[2]), U10.P21 (VCCPD5A), U10.R8 (VCCIO3B[4]), U10.R18 (VCCIO5A[2]), U10.R19 (VCCPGM[3]), U10.T6 (VCCIO3A[2]), U10.T11 (VCCIO3B[4]), U10.U14 (VCCIO4A[6]), U10.U19 (VCCIO4A[6]), U10.V8 (VCCPGM[3]), U10.W6 (VCCPD3A), U10.W10 (VCCIO3B[4]), U10.W11 (VCCPD3B4A[4]), U10.W12 (VCCPD3B4A[4]), U10.W14 (VCCPD3B4A[4]), U10.W15 (VCCIO4A[6]), U10.W17 (VCCPD3B4A[4]), U10.W20 (VCCIO4A[6]), U10.Y8 (VCCIO3A[2]), U10.Y13 (VCCIO3B[4]), U18.5 (VDD_IN), U19.8 (V_{CC}), Y4.1 (EN), Y4.4 (Vdd); also elsewhere on the board
/fpga/CLK0: R81.2, U10.E10 (CIO)
/fpga/CLK1: R92.2, U10.N16 (CIO)
/fpga/CT.A0: U10.U11 (IO); also elsewhere on the board
/fpga/CT.A1: U10.P12 (IO); also elsewhere on the board
/fpga/CT.A2: U10.Y10 (IO); also elsewhere on the board
/fpga/CT.A3: U10.R11 (IO); also elsewhere on the board
/fpga/CT.A4: U10.Y11 (IO); also elsewhere on the board
/fpga/CT.A5: U10.AB11 (IO); also elsewhere on the board
/fpga/CT.A6: U10.V10 (IO); also elsewhere on the board
/fpga/CT.A7: U10.AB10 (IO); also elsewhere on the board
/fpga/CT.A8: U10.Y9 (IO); also elsewhere on the board
/fpga/CT.A9: U10.AA10 (IO); also elsewhere on the board
/fpga/CT.A10: U10.T9 (IO); also elsewhere on the board
/fpga/CT.A11: U10.U10 (IO); also elsewhere on the board
/fpga/CT.A12: U10.V9 (IO); also elsewhere on the board
/fpga/CT.A13: U10.R10 (IO); also elsewhere on the board
/fpga/CT.A14: U10.AB12 (IO); also elsewhere on the board
/fpga/CT.A15: U10.T8 (IO); also elsewhere on the board
/fpga/CT.A16: U10.W9 (IO); also elsewhere on the board
/fpga/CT.A17: U10.T7 (IO); also elsewhere on the board
/fpga/CT.A18: U10.AA9 (IO); also elsewhere on the board
/fpga/CT.A19: U10.T10 (IO); also elsewhere on the board
/fpga/CT.A20: U10.W8 (IO); also elsewhere on the board
/fpga/CT.A21: U10.P9 (CIO); also elsewhere on the board
/fpga/CT.A22: U10.V6 (IO); also elsewhere on the board
/fpga/CT.A23: U10.AA7 (IO); also elsewhere on the board
/fpga/CT.A24: U10.N8 (IO); also elsewhere on the board
/fpga/CT.A25: U10.AB7 (IO); also elsewhere on the board
/fpga/CT.A26: U10.U6 (IO); also elsewhere on the board
/fpga/CT.A27: U10.AA8 (IO); also elsewhere on the board
/fpga/CT.A28: U10.P7 (IO); also elsewhere on the board
/fpga/CT.A29: U10.U8 (IO); also elsewhere on the board
/fpga/CT.A30: U10.AB5 (IO); also elsewhere on the board
/fpga/CT.A31: U10.AB8 (IO); also elsewhere on the board
/fpga/CT.BB_N: U10.R5 (IO); also elsewhere on the board
/fpga/CT.BG_N: U10.P6 (IO); also elsewhere on the board
/fpga/CT.BR_N: U10.N6 (IO); also elsewhere on the board
/fpga/CT.BS_N0: U10.P22 (IO); also elsewhere on the board
/fpga/CT.BS_N1: U10.P18 (IO); also elsewhere on the board
/fpga/CT.BS_N2: U10.T19 (IO); also elsewhere on the board
/fpga/CT.BS_N3: U10.T20 (IO); also elsewhere on the board
/fpga/CT.CLK: U10.W16 (CIO); also elsewhere on the board
/fpga/CT.D0: U10.M18 (IO); also elsewhere on the board
/fpga/CT.D1: U10.M22 (IO); also elsewhere on the board
/fpga/CT.D2: U10.L18 (IO); also elsewhere on the board
/fpga/CT.D3: U10.P17 (IO); also elsewhere on the board
/fpga/CT.D4: U10.M21 (IO); also elsewhere on the board
/fpga/CT.D5: U10.P16 (IO); also elsewhere on the board
/fpga/CT.D6: U10.N20 (IO); also elsewhere on the board
/fpga/CT.D7: U10.N21 (IO); also elsewhere on the board
/fpga/CT.D8: U10.R22 (IO); also elsewhere on the board
/fpga/CT.D9: U10.P14 (IO); also elsewhere on the board
/fpga/CT.D10: U10.R14 (IO); also elsewhere on the board
/fpga/CT.D11: U10.R21 (IO); also elsewhere on the board
/fpga/CT.D12: U10.T15 (IO); also elsewhere on the board
/fpga/CT.D13: U10.AA20 (IO); also elsewhere on the board
/fpga/CT.D14: U10.T18 (IO); also elsewhere on the board
/fpga/CT.D15: U10.R16 (IO); also elsewhere on the board
/fpga/CT.D16: U10.V21 (IO); also elsewhere on the board
/fpga/CT.D17: U10.U22 (IO); also elsewhere on the board
/fpga/CT.D18: U10.T14 (IO); also elsewhere on the board
/fpga/CT.D19: U10.U21 (IO); also elsewhere on the board
/fpga/CT.D20: U10.U20 (IO); also elsewhere on the board
/fpga/CT.D21: U10.U15 (IO); also elsewhere on the board
/fpga/CT.D22: U10.W22 (IO); also elsewhere on the board
/fpga/CT.D23: U10.W21 (IO); also elsewhere on the board
/fpga/CT.D24: U10.Y22 (IO); also elsewhere on the board
/fpga/CT.D25: U10.Y21 (IO); also elsewhere on the board
/fpga/CT.D26: U10.T17 (IO); also elsewhere on the board
/fpga/CT.D27: U10.AA22 (IO); also elsewhere on the board
/fpga/CT.D28: U10.AB22 (IO); also elsewhere on the board
/fpga/CT.D29: U10.V20 (IO); also elsewhere on the board
/fpga/CT.D30: U10.Y20 (IO); also elsewhere on the board
/fpga/CT.D31: U10.V19 (IO); also elsewhere on the board
/fpga/CT.DTKCMB_N: U10.P8 (IO); also elsewhere on the board
/fpga/CT.I6_N: U10.L19 (IO); also elsewhere on the board
/fpga/CT.RST_N: U10.AA12 (IO); also elsewhere on the board
/fpga/CT.RW: U10.R7 (IO); also elsewhere on the board
/fpga/CT.SIZ0: U10.AB6 (IO); also elsewhere on the board
/fpga/CT.SIZ1: U10.R9 (IO); also elsewhere on the board
/fpga/CT.TA_N: U10.U7 (IO); also elsewhere on the board
/fpga/CT.TEA_N: U10.N9 (CIO); also elsewhere on the board
/fpga/CT.TM0: U10.L17 (IO); also elsewhere on the board
/fpga/CT.TM1: U10.L22 (IO); also elsewhere on the board
/fpga/CT.TM2: U10.M20 (IO); also elsewhere on the board
/fpga/CT.TS_N: U10.R6 (IO); also elsewhere on the board
/fpga/CT.TT0: U10.N19 (IO); also elsewhere on the board
/fpga/CT.TT1: U10.P19 (IO); also elsewhere on the board
/fpga/DRAM.A0: U10.L7 (IO); also elsewhere on the board
/fpga/DRAM.A1: U10.K7 (IO); also elsewhere on the board
/fpga/DRAM.A2: U10.H8 (IO); also elsewhere on the board
/fpga/DRAM.A3: U10.G8 (IO); also elsewhere on the board
/fpga/DRAM.A4: U10.J7 (IO); also elsewhere on the board
/fpga/DRAM.A5: U10.J8 (IO); also elsewhere on the board
/fpga/DRAM.A6: U10.A10 (IO); also elsewhere on the board
/fpga/DRAM.A7: U10.A9 (IO); also elsewhere on the board
/fpga/DRAM.A8: U10.A8 (IO); also elsewhere on the board
/fpga/DRAM.A9: U10.A7 (IO); also elsewhere on the board
/fpga/DRAM.A10: U10.C6 (IO); also elsewhere on the board
/fpga/DRAM.A11: U10.D6 (IO); also elsewhere on the board
/fpga/DRAM.A12: U10.D7 (IO); also elsewhere on the board
/fpga/DRAM.A13: U10.C8 (IO); also elsewhere on the board
/fpga/DRAM.A14: U10.G6 (IO); also elsewhere on the board
/fpga/DRAM.BA0: U10.A5 (IO); also elsewhere on the board
/fpga/DRAM.BA1: U10.B10 (IO); also elsewhere on the board
/fpga/DRAM.BA2: U10.C9 (IO); also elsewhere on the board
/fpga/DRAM.CAS_N: U10.B6 (IO); also elsewhere on the board
/fpga/DRAM.CKE: U10.F14 (IO); also elsewhere on the board
/fpga/DRAM.CK_N: U10.H9 (IO); also elsewhere on the board
/fpga/DRAM.CK_P: U10.J9 (IO); also elsewhere on the board
/fpga/DRAM.CS_N: U10.E9 (IO); also elsewhere on the board
/fpga/DRAM.DM0: U10.F12 (IO); also elsewhere on the board
/fpga/DRAM.DM1: U10.A13 (IO); also elsewhere on the board
/fpga/DRAM.DM2: U10.D17 (IO); also elsewhere on the board
/fpga/DRAM.DM3: U10.A20 (IO); also elsewhere on the board
/fpga/DRAM.DQ0: U10.C11 (IO); also elsewhere on the board
/fpga/DRAM.DQ1: U10.G11 (IO); also elsewhere on the board
/fpga/DRAM.DQ2: U10.D12 (IO); also elsewhere on the board
/fpga/DRAM.DQ3: U10.D13 (IO); also elsewhere on the board
/fpga/DRAM.DQ4: U10.C13 (IO); also elsewhere on the board
/fpga/DRAM.DQ5: U10.K9 (IO); also elsewhere on the board
/fpga/DRAM.DQ6: U10.B12 (IO); also elsewhere on the board
/fpga/DRAM.DQ7: U10.E12 (IO); also elsewhere on the board
/fpga/DRAM.DQ8: U10.B15 (IO); also elsewhere on the board
/fpga/DRAM.DQ9: U10.E14 (IO); also elsewhere on the board
/fpga/DRAM.DQ10: U10.K16 (IO); also elsewhere on the board
/fpga/DRAM.DQ11: U10.J17 (IO); also elsewhere on the board
/fpga/DRAM.DQ12: U10.J11 (IO); also elsewhere on the board
/fpga/DRAM.DQ13: U10.G15 (IO); also elsewhere on the board
/fpga/DRAM.DQ14: U10.C15 (IO); also elsewhere on the board
/fpga/DRAM.DQ15: U10.F13 (IO); also elsewhere on the board
/fpga/DRAM.DQ16: U10.G17 (IO); also elsewhere on the board
/fpga/DRAM.DQ17: U10.C16 (IO); also elsewhere on the board
/fpga/DRAM.DQ18: U10.J18 (IO); also elsewhere on the board
/fpga/DRAM.DQ19: U10.F15 (IO); also elsewhere on the board
/fpga/DRAM.DQ20: U10.E16 (IO); also elsewhere on the board
/fpga/DRAM.DQ21: U10.B16 (IO); also elsewhere on the board
/fpga/DRAM.DQ22: U10.A15 (IO); also elsewhere on the board
/fpga/DRAM.DQ23: U10.E15 (IO); also elsewhere on the board
/fpga/DRAM.DQ24: U10.A18 (IO); also elsewhere on the board
/fpga/DRAM.DQ25: U10.D22 (IO); also elsewhere on the board
/fpga/DRAM.DQ26: U10.C18 (IO); also elsewhere on the board
/fpga/DRAM.DQ27: U10.E22 (IO); also elsewhere on the board
/fpga/DRAM.DQ28: U10.C19 (IO); also elsewhere on the board
/fpga/DRAM.DQ29: U10.B22 (IO); also elsewhere on the board
/fpga/DRAM.DQ30: U10.A17 (IO); also elsewhere on the board
/fpga/DRAM.DQ31: U10.F20 (IO); also elsewhere on the board
/fpga/DRAM.DQS_N0: U10.G12 (IO); also elsewhere on the board
/fpga/DRAM.DQS_N1: U10.J13 (IO); also elsewhere on the board
/fpga/DRAM.DQS_N2: U10.H18 (IO); also elsewhere on the board
/fpga/DRAM.DQS_N3: U10.F18 (IO); also elsewhere on the board
/fpga/DRAM.DQS_P0: U10.H11 (IO); also elsewhere on the board
/fpga/DRAM.DQS_P1: U10.H14 (IO); also elsewhere on the board
/fpga/DRAM.DQS_P2: U10.G18 (IO); also elsewhere on the board
/fpga/DRAM.DQS_P3: U10.F19 (IO); also elsewhere on the board
/fpga/DRAM.ODT: U10.L8 (IO); also elsewhere on the board
/fpga/DRAM.RAS_N: U10.B7 (IO); also elsewhere on the board
/fpga/DRAM.RESET_N: U10.J19 (IO); also elsewhere on the board
/fpga/DRAM.RZQ: R71.2, U10.B11 (IO)
/fpga/DRAM.WE_N: U10.F7 (IO); also elsewhere on the board
/fpga/ETH.A1: U10.AA17 (IO); also elsewhere on the board
/fpga/ETH.A2: U10.AB18 (IO); also elsewhere on the board
/fpga/ETH.A3: U10.AA18 (IO); also elsewhere on the board
/fpga/ETH.A4: U10.AA19 (IO); also elsewhere on the board
/fpga/ETH.A5: U10.AB20 (IO); also elsewhere on the board
/fpga/ETH.A6: U10.T22 (IO); also elsewhere on the board
/fpga/ETH.A7: U10.AB21 (IO); also elsewhere on the board
/fpga/ETH.CS_N: U10.AB15 (IO); also elsewhere on the board
/fpga/ETH.D0: U10.T13 (IO); also elsewhere on the board
/fpga/ETH.D1: U10.U12 (IO); also elsewhere on the board
/fpga/ETH.D2: U10.T12 (IO); also elsewhere on the board
/fpga/ETH.D3: U10.R12 (IO); also elsewhere on the board
/fpga/ETH.D4: U10.V13 (IO); also elsewhere on the board
/fpga/ETH.D5: U10.Y14 (IO); also elsewhere on the board
/fpga/ETH.D6: U10.R15 (IO); also elsewhere on the board
/fpga/ETH.D7: U10.Y15 (IO); also elsewhere on the board
/fpga/ETH.D8: U10.U16 (IO); also elsewhere on the board
/fpga/ETH.D9: U10.U17 (IO); also elsewhere on the board
/fpga/ETH.D10: U10.V18 (IO); also elsewhere on the board
/fpga/ETH.D11: U10.Y19 (IO); also elsewhere on the board
/fpga/ETH.D12: U10.W19 (IO); also elsewhere on the board
/fpga/ETH.D13: U10.AB13 (IO); also elsewhere on the board
/fpga/ETH.D14: U10.AA14 (IO); also elsewhere on the board
/fpga/ETH.D15: U10.AA15 (IO); also elsewhere on the board
/fpga/ETH.FIFO_SEL: U10.AB17 (IO); also elsewhere on the board
/fpga/ETH.IRQ: U10.AA13 (IO); also elsewhere on the board
/fpga/ETH.RD_N: U10.Y17 (IO); also elsewhere on the board
/fpga/ETH.RESET_N: U10.U13 (IO); also elsewhere on the board
/fpga/ETH.WR_N: U10.Y16 (IO); also elsewhere on the board
/fpga/FALCON_AUDIOLV.I0: U10.D21 (IO); also elsewhere on the board
/fpga/FALCON_AUDIOLV.I1: U10.C20 (IO); also elsewhere on the board
/fpga/FALCON_AUDIOLV.I2: U10.E19 (IO); also elsewhere on the board
/fpga/FALCON_AUDIOLV.O: U10.D19 (IO); also elsewhere on the board
/fpga/HDMI.CLK_N: U10.F9 (CIO); also elsewhere on the board
/fpga/HDMI.CLK_P: U10.H6 (IO); also elsewhere on the board
/fpga/HDMI.I2CRESET: U10.M8 (CIO); also elsewhere on the board
/fpga/HDMI.REFCLK_N: U10.F5 (CI); also elsewhere on the board
/fpga/HDMI.REFCLK_P: U10.G4 (CI); also elsewhere on the board
/fpga/HDMI.SCL: U10.M6 (IO); also elsewhere on the board
/fpga/HDMI.SDA: U10.M7 (IO); also elsewhere on the board
/fpga/HDMI.TX_N0: U10.D3 (GXB_TX_L5n); also elsewhere on the board
/fpga/HDMI.TX_N1: U10.E1 (GXB_TX_L4n); also elsewhere on the board
/fpga/HDMI.TX_N2: U10.J1 (GXB_TX_L3n); also elsewhere on the board
/fpga/HDMI.TX_P0: U10.D4 (GXB_TX_L5p); also elsewhere on the board
/fpga/HDMI.TX_P1: U10.E2 (GXB_TX_L4p); also elsewhere on the board
/fpga/HDMI.TX_P2: U10.J2 (GXB_TX_L3p); also elsewhere on the board
/fpga/LINK.RX_N: U10.R1 (CI); also elsewhere on the board
/fpga/LINK.RX_P: U10.R2 (CI); also elsewhere on the board
/fpga/LINK.TX_N: U10.N1 (GXB_TX_L2n); also elsewhere on the board
/fpga/LINK.TX_P: U10.N2 (GXB_TX_L2p); also elsewhere on the board
/fpga/Net-(U5power-RREF_TL): R12.1, U10.A1 (RREF_TL)
/fpga/Net-(U5special-AS_DATA1): R113.2, U10.AB3 (AS_DATA1)
/fpga/Net-(U5special-CONF_DONE): R88.2, U10.K6 (CONF_DONE)
/fpga/Net-(U5special-nCONFIG): R76.2, U10.A4 (nCONFIG)
/fpga/Net-(U5special-nSTATUS): R16.2, U10.H5 (nSTATUS)
/fpga/Net-(U6-CLK_IN): R93.2, U18.1 (CLK_IN)
/fpga/Net-(U6-CLK_OUT): R81.1, U18.4 (CLK_OUT)
/fpga/Net-(U29-C/CLK): U10.V3 (DCLK), U19.6 (C/CLK)
/fpga/Net-(U29-DQ0/SI): U10.AB4 (DATA0), U19.5 (DQ0/SI)
/fpga/Net-(U29-DQ1/SO): R113.1, U19.2 (DQ1/SO)
/fpga/Net-(U29-~HOLD): R122.2, U10.T4 (AS_DATA3), U19.7 (~HOLD)
/fpga/Net-(U29-~S/~CS): R127.2, U10.R4 (nCSO), U19.1 (~S/~CS)
/fpga/Net-(U29-~W/V_{PP}): R108.2, U10.AA5 (AS_DATA2), U19.3 (~W/V_{PP})
/fpga/Net-(Y6-OUT): R92.1, R93.1, Y4.3 (OUT)
/fpga/PCIE.PERST_N: U10.R17 (IO); also elsewhere on the board
/fpga/PCIE.REFCLK_N: U10.U4 (CI); also elsewhere on the board
/fpga/PCIE.REFCLK_P: U10.V4 (CI); also elsewhere on the board
/fpga/PCIE.RX_N: U10.AA1 (CI); also elsewhere on the board
/fpga/PCIE.RX_P: U10.AA2 (CI); also elsewhere on the board
/fpga/PCIE.SPARE: U10.M9 (CIO); also elsewhere on the board
/fpga/PCIE.TX_N: U10.Y3 (GXB_TX_L0n); also elsewhere on the board
/fpga/PCIE.TX_P: U10.Y4 (GXB_TX_L0p); also elsewhere on the board
/fpga/TCK: J3.1, R32.1, U10.V5 (TCK)
/fpga/TDI: J3.9, R22.2, U10.W5 (TDI)
/fpga/TDO: J3.3, U10.M5 (TDO)
/fpga/TMS: J3.5, R25.2, U10.P5 (TMS)
/fpga/USB2.CLK: U10.M16 (CIO); also elsewhere on the board
/fpga/USB2.DIR: U10.K22 (IO); also elsewhere on the board
/fpga/USB2.NXT: U10.K21 (IO); also elsewhere on the board
/fpga/USB2.STP: U10.K17 (IO); also elsewhere on the board
/fpga/USB2LV.DATA0: U10.H15 (CIO); also elsewhere on the board
/fpga/USB2LV.DATA1: U10.J21 (IO); also elsewhere on the board
/fpga/USB2LV.DATA2: U10.J22 (IO); also elsewhere on the board
/fpga/USB2LV.DATA3: U10.H16 (CIO); also elsewhere on the board
/fpga/USB2LV.DATA4: U10.H13 (CIO); also elsewhere on the board
/fpga/USB2LV.DATA5: U10.G22 (IO); also elsewhere on the board
/fpga/USB2LV.DATA6: U10.G13 (CIO); also elsewhere on the board
/fpga/USB2LV.DATA7: U10.E21 (IO); also elsewhere on the board
/fpga/VIDEL33.CLK0: U10.V15 (CIO); also elsewhere on the board
/fpga/VIDEL33.CLK1: U10.V16 (CIO); also elsewhere on the board
/fpga/VIDEL33.CLK2: U10.V14 (CIO); also elsewhere on the board
/fpga/unconnected-(J22-Pin_6-Pad6): J3.6
/fpga/unconnected-(J22-Pin_7-Pad7): J3.7
/fpga/unconnected-(J22-Pin_8-Pad8): J3.8
/fpga/unconnected-(U5bank7A-IO-PadA12): U10.A12 (IO)
/fpga/unconnected-(U5bank7A-IO-PadA19): U10.A19 (IO)
/fpga/unconnected-(U5bank7A-IO-PadA22): U10.A22 (IO)
/fpga/unconnected-(U5bank7A-IO-PadB13): U10.B13 (IO)
/fpga/unconnected-(U5bank7A-IO-PadB17): U10.B17 (IO)
/fpga/unconnected-(U5bank7A-IO-PadB18): U10.B18 (IO)
/fpga/unconnected-(U5bank7A-IO-PadB20): U10.B20 (IO)
/fpga/unconnected-(U5bank7A-IO-PadB21): U10.B21 (IO)
/fpga/unconnected-(U5bank7A-IO-PadC21): U10.C21 (IO)
/fpga/unconnected-(U5bank7A-IO-PadE20): U10.E20 (IO)
/fpga/unconnected-(U5bank7A-IO-PadF22): U10.F22 (IO)
/fpga/unconnected-(U5bank7A-IO-PadG20): U10.G20 (IO)
/fpga/unconnected-(U5bank7A-IO-PadG21): U10.G21 (IO)
/fpga/unconnected-(U5bank7A-IO-PadH20): U10.H20 (IO)
/fpga/unconnected-(U5bank7A-IO-PadH21): U10.H21 (IO)
/fpga/unconnected-(U5bank8A-CIO-PadF10): U10.F10 (CIO)
/fpga/unconnected-(U5bank8A-CIO-PadG10): U10.G10 (CIO)
/fpga/unconnected-(U5bank8A-IO-PadD9): U10.D9 (IO)
/fpga/unconnected-(U5bankG0-GXB_TX_L1n-PadU1): U10.U1 (GXB_TX_L1n)
/fpga/unconnected-(U5bankG0-GXB_TX_L1p-PadU2): U10.U2 (GXB_TX_L1p)
GND: C79.2, C80.2, C82.2, C83.2, C84.2, C85.2, C86.2, C88.2, C89.2, C90.1, C91.2, C92.2, C93.2, C94.2, C95.2, C96.2, C97.2, C98.2, C99.2, C100.2, C101.2, C102.2, C103.2, C104.2, C105.2, C107.2, C108.2, C109.2, C110.2, C111.2, C112.2, J3.2, J3.10, R12.2, R32.2, R71.1, R98.1, U10.A2 (MSEL2), U10.A11 (GND[98]), U10.A14 (IO), U10.A21 (GND[98]), U10.AA3 (GND[98]), U10.AA4 (GND[98]), U10.AA6 (GND[98]), U10.AA11 (GND[98]), U10.AB1 (GND[98]), U10.AB2 (GND[98]), U10.AB9 (GND[98]), U10.AB14 (GND[98]), U10.AB16 (VREFB4AN0), U10.AB19 (GND[98]), U10.B1 (GND[98]), U10.B2 (GND[98]), U10.B5 (IO), U10.B9 (GND[98]), U10.B14 (GND[98]), U10.C1 (CI), U10.C2 (CI), U10.C3 (GND[98]), U10.C4 (GND[98]), U10.C5 (GND[98]), U10.C17 (GND[98]), U10.D1 (GND[98]), U10.D2 (GND[98]), U10.D5 (GND[98]), U10.D10 (GND[98]), U10.D20 (GND[98]), U10.E3 (GND[98]), U10.E4 (GND[98]), U10.E5 (MSEL3), U10.E7 (IO), U10.E13 (GND[98]), U10.F1 (GND[98]), U10.F2 (GND[98]), U10.F6 (GND[98]), U10.F16 (GND[98]), U10.F17 (GND[98]), U10.G1 (CI), U10.G2 (CI), U10.G3 (GND[98]), U10.G5 (nCE), U10.G9 (GND[98]), U10.G16 (IO), U10.G19 (GND[98]), U10.H1 (GND[98]), U10.H2 (GND[98]), U10.H3 (GND[98]), U10.H4 (GND[98]), U10.H7 (GND[98]), U10.H10 (IO), U10.H12 (GND[98]), U10.H22 (GND[98]), U10.J3 (GND[98]), U10.J5 (GND[98]), U10.J15 (GND[98]), U10.J20 (GND[98]), U10.K1 (GND[98]), U10.K2 (GND[98]), U10.K4 (GND[98]), U10.K8 (GND[98]), U10.K10 (GND[98]), U10.K12 (GND[98]), U10.K14 (GND[98]), U10.K19 (IO), U10.K20 (IO), U10.L1 (CI), U10.L2 (CI), U10.L3 (GND[98]), U10.L5 (GND[98]), U10.L11 (GND[98]), U10.L13 (GND[98]), U10.L15 (GND[98]), U10.L20 (VREFB5BN0), U10.L21 (GND[98]), U10.M1 (GND[98]), U10.M2 (GND[98]), U10.M4 (GND[98]), U10.M10 (GND[98]), U10.M12 (GND[98]), U10.M14 (GND[98]), U10.N3 (GND[98]), U10.N5 (GND[98]), U10.N7 (GND[98]), U10.N11 (GND[98]), U10.N13 (GND[98]), U10.N15 (GND[98]), U10.N17 (GND[98]), U10.N22 (GND[98]), U10.P1 (GND[98]), U10.P2 (GND[98]), U10.P4 (GND[98]), U10.P10 (GND[98]), U10.R3 (GND[98]), U10.R13 (GND[98]), U10.R20 (VREFB5AN0), U10.T1 (GND[98]), U10.T2 (GND[98]), U10.T16 (GND[98]), U10.T21 (GND[98]), U10.U3 (GND[98]), U10.U5 (GND[98]), U10.U9 (GND[98]), U10.V1 (GND[98]), U10.V2 (GND[98]), U10.V7 (GND[98]), U10.V12 (GND[98]), U10.V17 (GND[98]), U10.V22 (GND[98]), U10.W1 (CI), U10.W2 (CI), U10.W3 (GND[98]), U10.W4 (GND[98]), U10.Y1 (GND[98]), U10.Y2 (GND[98]), U10.Y5 (GND[98]), U10.Y7 (VREFB3AN0), U10.Y12 (VREFB3BN0), U10.Y18 (GND[98]), U18.3 (GND), U19.4 (V_{SS}), Y4.2 (GND); also elsewhere on the board
unnamed: R94.2, R98.2, U10.L6 (MSEL0)

Notes on the sheet:
VCCPGM
T22 is nCEO, careful
