scrameta/mega_videl/board/kicad/mega_videl/mega_videl.kicad_pcb

## KiCad design board/kicad/mega_videl/mega_videl.kicad_pcb (continued)

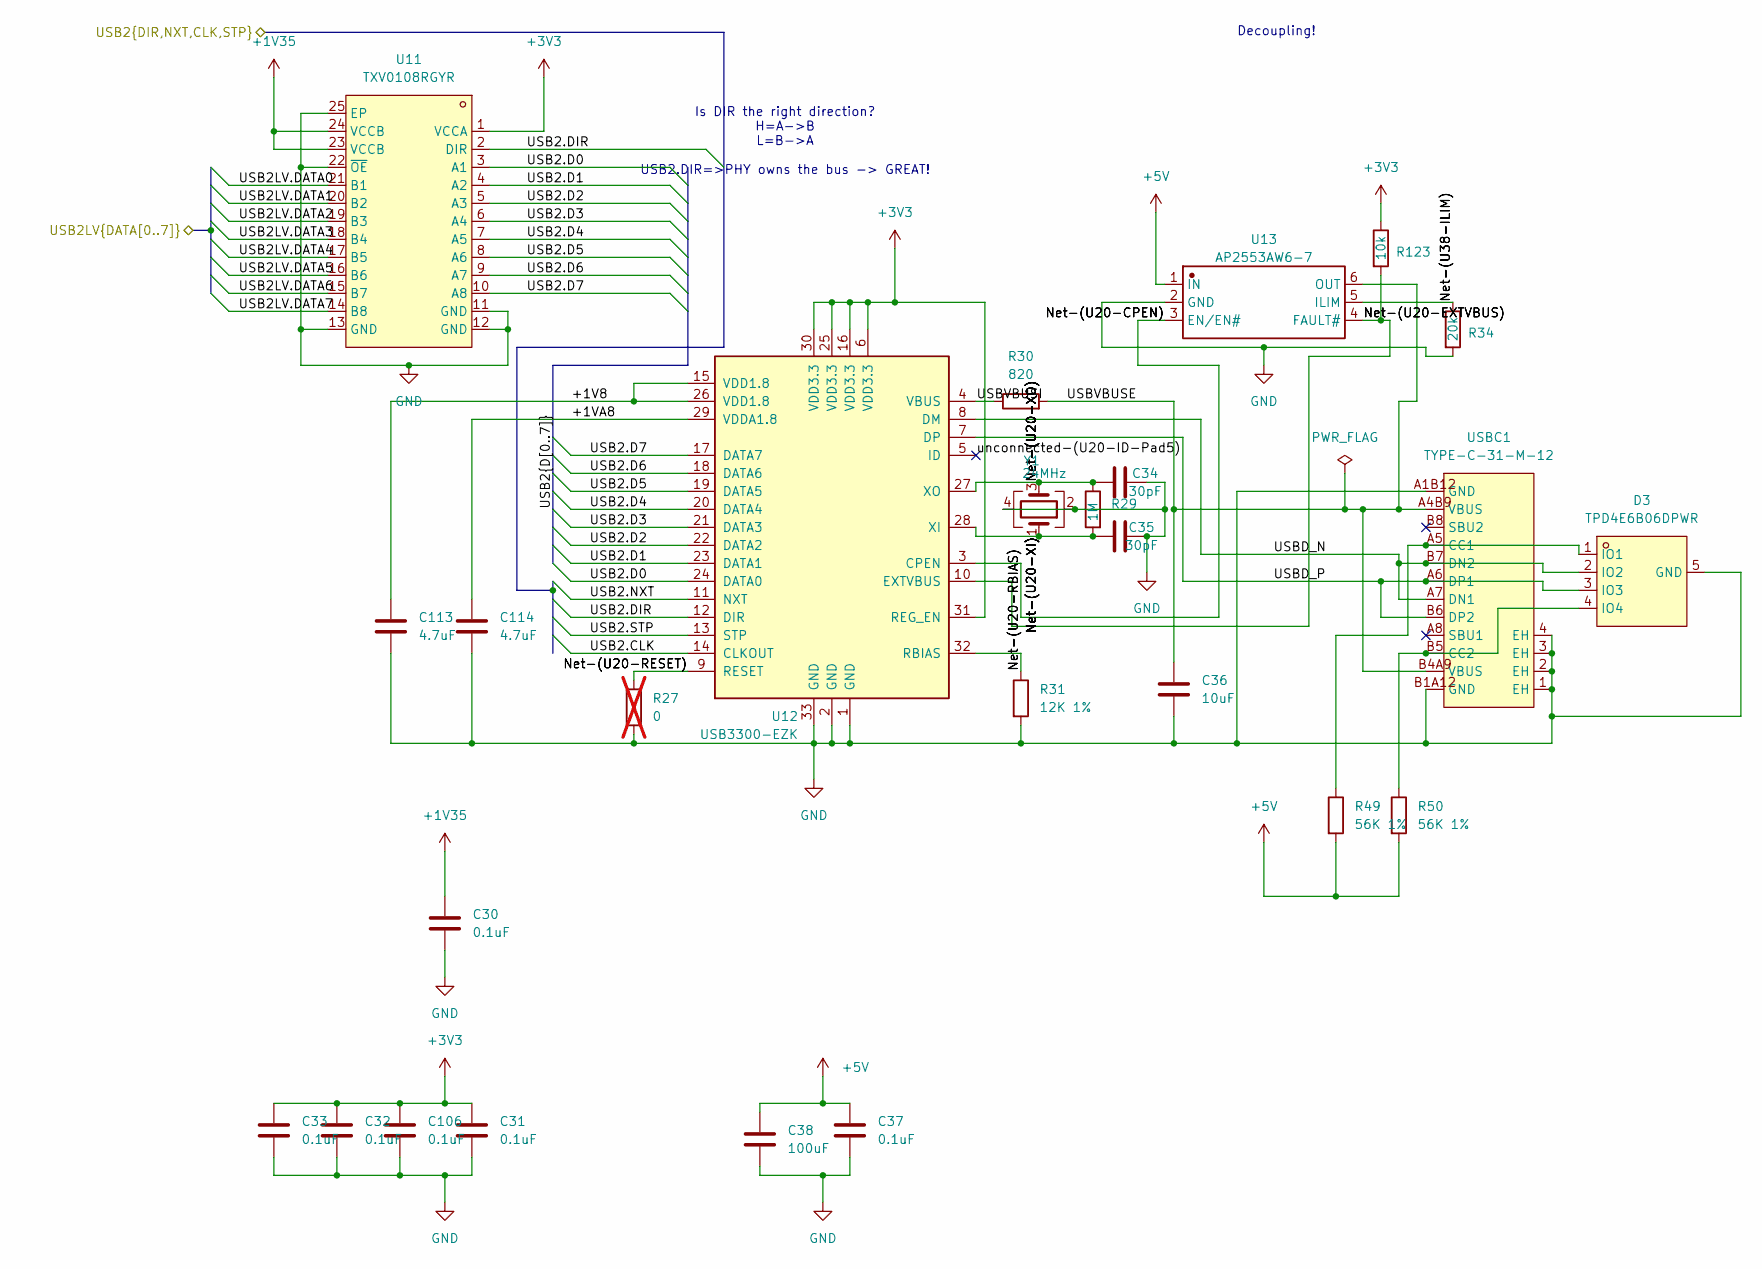
[picture p8: schematic usb2.kicad_sch]

Parts:
C30, C31, C32, C33, C37, C106: 0.1uF; C_0603_1608Metric; LCSC C14663
C34, C35: 30pF; C_0603_1608Metric; LCSC C1658
C36: 10uF; C_0805_2012Metric; LCSC C15850
C38: 100uF; C_1206_3216Metric; LCSC C7432784
C113, C114: 4.7uF; C_0805_2012Metric; LCSC C1779
D3: TPD4E6B06DPWR; X2SON-4_L0.8-W0.8-P0.48-TL-A; MPN TPD4E6B06DPWR; LCSC Part C2869397
R27: 0; R_0603_1608Metric; LCSC C21189; not fitted
R29: 1M; R_0603_1608Metric; LCSC C22935
R30: 820; R_0603_1608Metric; LCSC C23253
R31: 12K 1%; R_0603_1608Metric; LCSC C22790
R34: 20k; R_0603_1608Metric; LCSC C4184
R49, R50: 56K 1%; R_0603_1608Metric; LCSC C23206
R123: 10k; R_0603_1608Metric; LCSC C25804
U11: TXV0108RGYR; TQFN-24_L5.5-W3.5-P0.50-BR-EP; MPN TXV0108RGYR; LCSC Part C22428389
U12: USB3300-EZK; QFN-32-1EP_5x5mm_P0.5mm_EP3.45x3.45mm; LCSC C108383
U13: AP2553AW6-7; SOT-26_L3.0-W1.6-P0.95-LS2.8-BL; Manufacturer Part AP2553AW6-7; JLC_3DModel df0aaac1b0f04609b13717eddf3d6f89
USBC1: TYPE-C-31-M-12; USB-C_SMD-TYPE-C-31-M-12_1; MPN TYPE-C-31-M-12; LCSC Part C165948
Y1: 24MHz; Crystal_SMD_3225-4Pin_3.2x2.5mm; LCSC C5308006

Connections:
+1V35: C30.1, U11.23 (VCCB), U11.24 (VCCB); also elsewhere on the board
+3V3: C31.1, C32.1, C33.1, C106.1, R123.1, U11.1 (VCCA), U12.6 (VDD3.3), U12.16 (VDD3.3), U12.25 (VDD3.3), U12.30 (VDD3.3), U12.31 (REG_EN); also elsewhere on the board
+5V: C37.1, C38.1, R49.2, R50.2, U13.1 (IN); also elsewhere on the board
/fpga/USB2.CLK: U12.14 (CLKOUT); also elsewhere on the board
/fpga/USB2.DIR: U11.2 (DIR), U12.12 (DIR); also elsewhere on the board
/fpga/USB2.NXT: U12.11 (NXT); also elsewhere on the board
/fpga/USB2.STP: U12.13 (STP); also elsewhere on the board
/fpga/USB2LV.DATA0: U11.21 (B1); also elsewhere on the board
/fpga/USB2LV.DATA1: U11.20 (B2); also elsewhere on the board
/fpga/USB2LV.DATA2: U11.19 (B3); also elsewhere on the board
/fpga/USB2LV.DATA3: U11.18 (B4); also elsewhere on the board
/fpga/USB2LV.DATA4: U11.17 (B5); also elsewhere on the board
/fpga/USB2LV.DATA5: U11.16 (B6); also elsewhere on the board
/fpga/USB2LV.DATA6: U11.15 (B7); also elsewhere on the board
/fpga/USB2LV.DATA7: U11.14 (B8); also elsewhere on the board
/usb2/+1V8: C113.1, U12.15 (VDD1.8), U12.26 (VDD1.8)
/usb2/+1VA8: C114.1, U12.29 (VDDA1.8)
/usb2/Net-(U20-CPEN): U12.3 (CPEN), U13.3 (EN/EN#)
/usb2/Net-(U20-EXTVBUS): R123.2, U12.10 (EXTVBUS), U13.4 (FAULT#)
/usb2/Net-(U20-RBIAS): R31.1, U12.32 (RBIAS)
/usb2/Net-(U20-RESET): R27.1, U12.9 (RESET)
/usb2/Net-(U20-XI): C35.2, R29.2, U12.28 (XI), Y1.1
/usb2/Net-(U20-XO): C34.2, R29.1, U12.27 (XO), Y1.3
/usb2/Net-(U38-ILIM): R34.1, U13.5 (ILIM)
/usb2/USB2.D0: U11.3 (A1), U12.24 (DATA0)
/usb2/USB2.D1: U11.4 (A2), U12.23 (DATA1)
/usb2/USB2.D2: U11.5 (A3), U12.22 (DATA2)
/usb2/USB2.D3: U11.6 (A4), U12.21 (DATA3)
/usb2/USB2.D4: U11.7 (A5), U12.20 (DATA4)
/usb2/USB2.D5: U11.8 (A6), U12.19 (DATA5)
/usb2/USB2.D6: U11.9 (A7), U12.18 (DATA6)
/usb2/USB2.D7: U11.10 (A8), U12.17 (DATA7)
/usb2/USBD_N: D3.2 (IO2), U12.8 (DM), USBC1.A7 (DN1), USBC1.B7 (DN2)
/usb2/USBD_P: D3.3 (IO3), U12.7 (DP), USBC1.A6 (DP1), USBC1.B6 (DP2)
/usb2/USBVBUSE: C36.1, R30.2, U13.6 (OUT), USBC1.A4B9 (VBUS), USBC1.B4A9 (VBUS)
/usb2/USBVBUSI: R30.1, U12.4 (VBUS)
/usb2/unconnected-(U20-ID-Pad5): U12.5 (ID)
GND: C30.2, C31.2, C32.2, C33.2, C34.1, C35.1, C36.2, C37.2, C38.2, C106.2, C113.2, C114.2, D3.5 (GND), R27.2, R31.2, R34.2, U11.11 (GND), U11.12 (GND), U11.13 (GND), U11.22 (~OE), U11.25 (EP), U12.1 (GND), U12.2 (GND), U12.33 (GND), U13.2 (GND), USBC1.1 (EH), USBC1.2 (EH), USBC1.3 (EH), USBC1.4 (EH), USBC1.A1B12 (GND), USBC1.B1A12 (GND), Y1.2, Y1.4; also elsewhere on the board
unnamed: D3.1 (IO1), R49.1, USBC1.A5 (CC1)
unnamed: D3.4 (IO4), R50.1, USBC1.B5 (CC2)

Notes on the sheet:
Is DIR the right direction? H=A->B L=B->A USB2.DIR=>PHY owns the bus -> GREAT!
Decoupling!

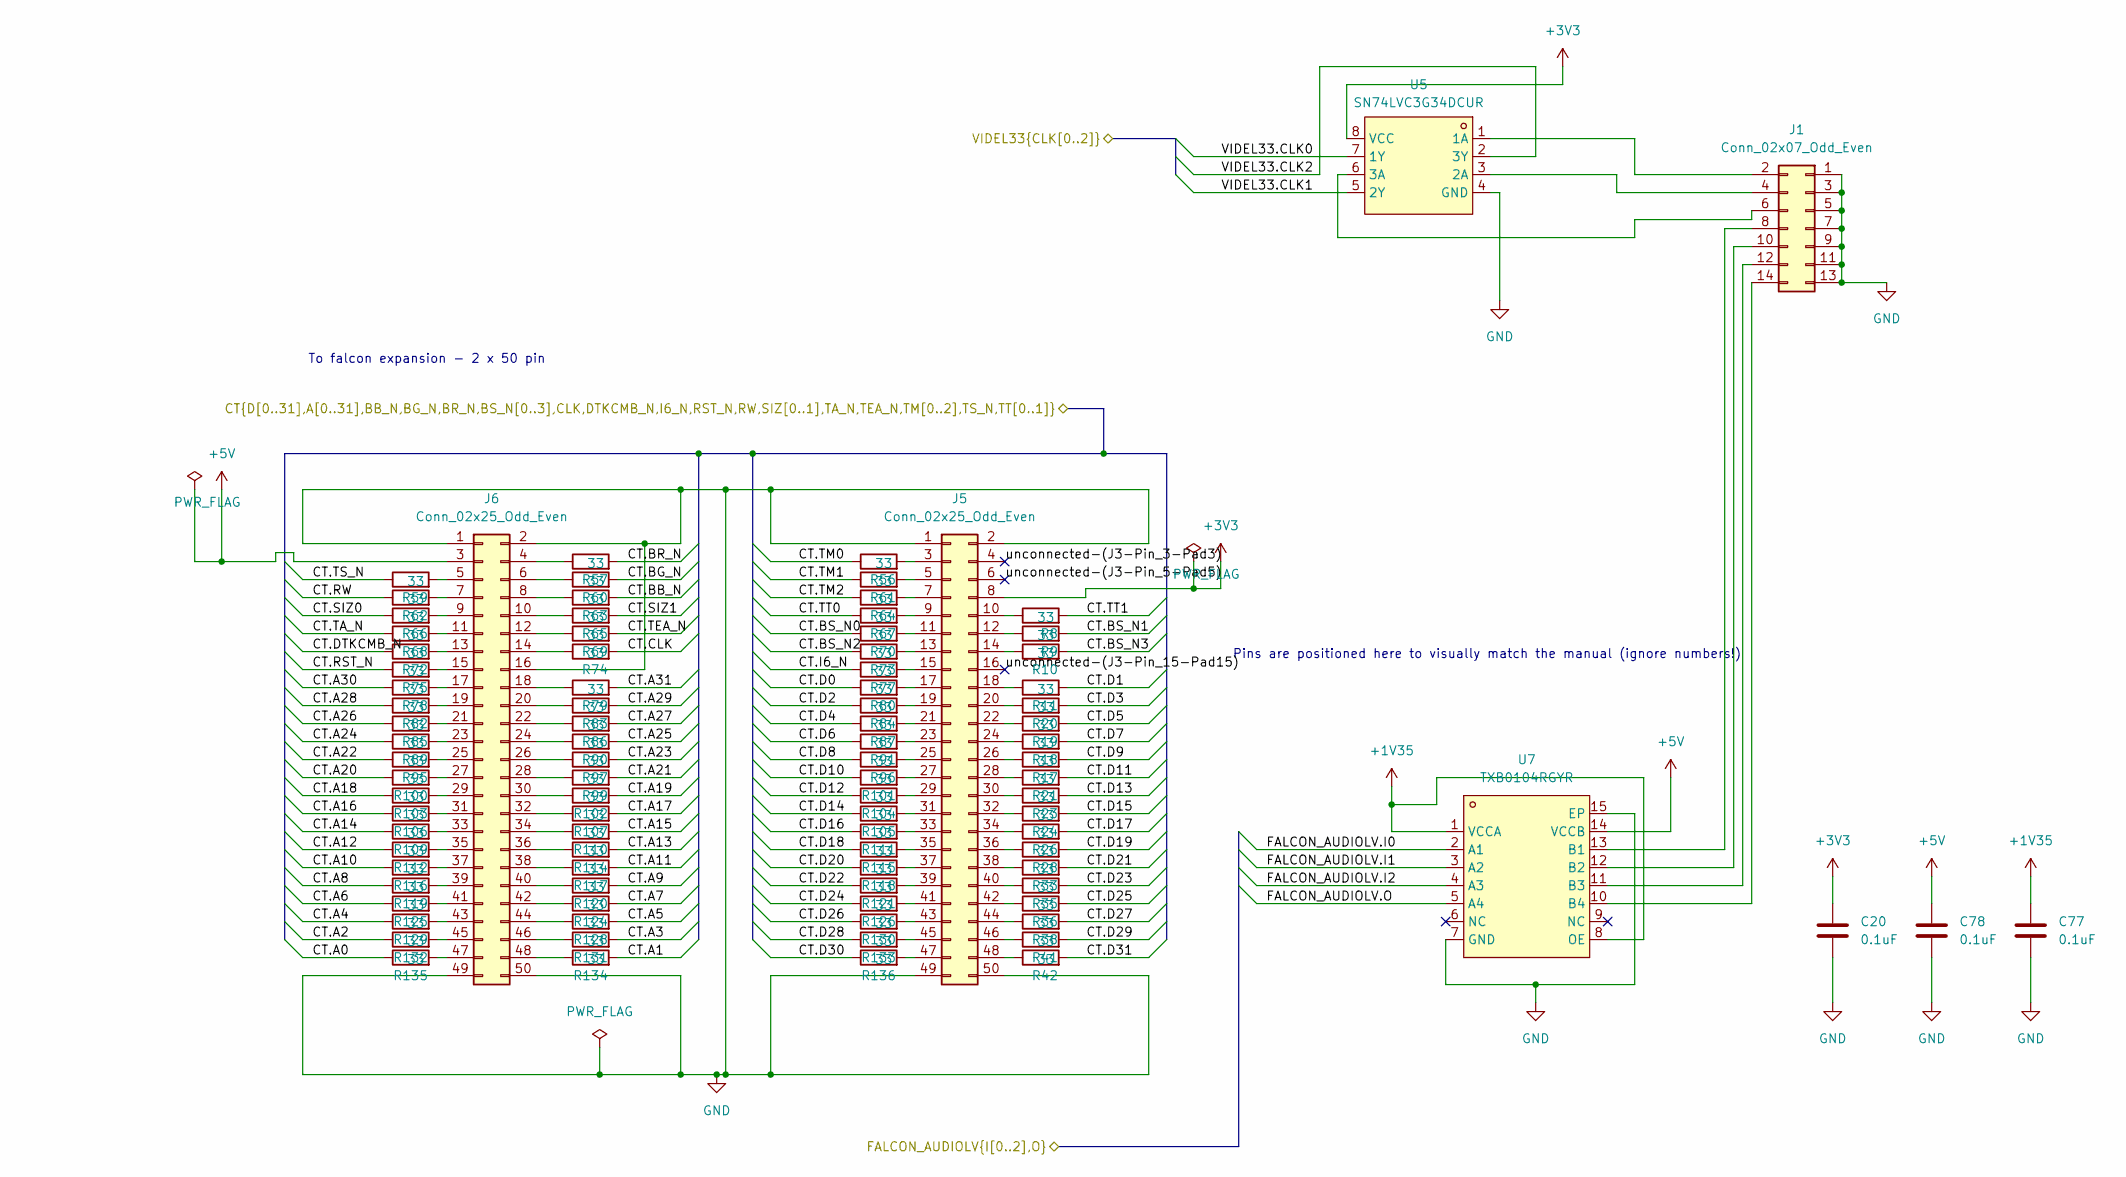
[picture p9: schematic expansion.kicad_sch]

Parts:
C20, C77, C78: 0.1uF; C_0603_1608Metric; LCSC C14663
J1: Conn_02x07_Odd_Even; PinHeader_2x07_P2.54mm_Vertical_SMD; LCSC C7366128
J5, J6: Conn_02x25_Odd_Even; PinSocket_2x25_P2.54mm_Vertical_SMD; LCSC C52611
R8, R9, R10, R11, R17, R18, R19, R20, R21, R23, R24, R26, R28, R33, R35, R36, R38, R41, R42, R56, R57, R59, R60, R61, R62, R63, R64, R65, R66, R67, R68, R69, R70, R72, R73, R74, R75, R77, R78, R79, R80, R82, R83, R84, R85, R86, R87, R89, R90, R91, R95, R96, R97, R99, R100, R101, R102, R103, R104, R105, R106, R107, R109, R110, R111, R112, R114, R115, R116, R117, R118, R119, R120, R121, R124, R125, R126, R128, R129, R130, R131, R132, R133, R134, R135, R136: 33; R_0402_1005Metric; LCSC C25105
U5: SN74LVC3G34DCUR; VSSOP-8_L2.1-W2.4-P0.50-LS3.2-BR; MPN SN74LVC3G34DCUR; LCSC Part C130024
U7: TXB0104RGYR; VQFN-14_L3.5-W3.5-P0.50-BL-EP; MPN TXB0104RGYR; LCSC Part C400708

Connections:
+1V35: C77.1, U7.1 (VCCA), U7.8 (OE); also elsewhere on the board
+3V3: C20.1, J5.8, U5.8 (VCC); also elsewhere on the board
+5V: C78.1, J6.3, U7.14 (VCCB); also elsewhere on the board
/expansion/unconnected-(J3-Pin_3-Pad3): J5.4
/expansion/unconnected-(J3-Pin_5-Pad5): J5.6
/expansion/unconnected-(J3-Pin_15-Pad15): J5.16
/fpga/CT.A0: R135.1; also elsewhere on the board
/fpga/CT.A1: R134.2; also elsewhere on the board
/fpga/CT.A2: R132.1; also elsewhere on the board
/fpga/CT.A3: R131.2; also elsewhere on the board
/fpga/CT.A4: R129.1; also elsewhere on the board
/fpga/CT.A5: R128.2; also elsewhere on the board
/fpga/CT.A6: R125.1; also elsewhere on the board
/fpga/CT.A7: R124.2; also elsewhere on the board
/fpga/CT.A8: R119.1; also elsewhere on the board
/fpga/CT.A9: R120.2; also elsewhere on the board
/fpga/CT.A10: R116.1; also elsewhere on the board
/fpga/CT.A11: R117.2; also elsewhere on the board
/fpga/CT.A12: R112.1; also elsewhere on the board
/fpga/CT.A13: R114.2; also elsewhere on the board
/fpga/CT.A14: R109.1; also elsewhere on the board
/fpga/CT.A15: R110.2; also elsewhere on the board
/fpga/CT.A16: R106.1; also elsewhere on the board
/fpga/CT.A17: R107.2; also elsewhere on the board
/fpga/CT.A18: R103.1; also elsewhere on the board
/fpga/CT.A19: R102.2; also elsewhere on the board
/fpga/CT.A20: R100.1; also elsewhere on the board
/fpga/CT.A21: R99.2; also elsewhere on the board
/fpga/CT.A22: R95.1; also elsewhere on the board
/fpga/CT.A23: R97.2; also elsewhere on the board
/fpga/CT.A24: R89.1; also elsewhere on the board
/fpga/CT.A25: R90.2; also elsewhere on the board
/fpga/CT.A26: R85.1; also elsewhere on the board
/fpga/CT.A27: R86.2; also elsewhere on the board
/fpga/CT.A28: R82.1; also elsewhere on the board
/fpga/CT.A29: R83.2; also elsewhere on the board
/fpga/CT.A30: R78.1; also elsewhere on the board
/fpga/CT.A31: R79.2; also elsewhere on the board
/fpga/CT.BB_N: R63.2; also elsewhere on the board
/fpga/CT.BG_N: R60.2; also elsewhere on the board
/fpga/CT.BR_N: R57.2; also elsewhere on the board
/fpga/CT.BS_N0: R70.1; also elsewhere on the board
/fpga/CT.BS_N1: R9.2; also elsewhere on the board
/fpga/CT.BS_N2: R73.1; also elsewhere on the board
/fpga/CT.BS_N3: R10.2; also elsewhere on the board
/fpga/CT.CLK: R74.2; also elsewhere on the board
/fpga/CT.D0: R80.1; also elsewhere on the board
/fpga/CT.D1: R11.2; also elsewhere on the board
/fpga/CT.D2: R84.1; also elsewhere on the board
/fpga/CT.D3: R20.2; also elsewhere on the board
/fpga/CT.D4: R87.1; also elsewhere on the board
/fpga/CT.D5: R19.2; also elsewhere on the board
/fpga/CT.D6: R91.1; also elsewhere on the board
/fpga/CT.D7: R18.2; also elsewhere on the board
/fpga/CT.D8: R96.1; also elsewhere on the board
/fpga/CT.D9: R17.2; also elsewhere on the board
/fpga/CT.D10: R101.1; also elsewhere on the board
/fpga/CT.D11: R21.2; also elsewhere on the board
/fpga/CT.D12: R104.1; also elsewhere on the board
/fpga/CT.D13: R23.2; also elsewhere on the board
/fpga/CT.D14: R105.1; also elsewhere on the board
/fpga/CT.D15: R24.2; also elsewhere on the board
/fpga/CT.D16: R111.1; also elsewhere on the board
/fpga/CT.D17: R26.2; also elsewhere on the board
/fpga/CT.D18: R115.1; also elsewhere on the board
/fpga/CT.D19: R28.2; also elsewhere on the board
/fpga/CT.D20: R118.1; also elsewhere on the board
/fpga/CT.D21: R33.2; also elsewhere on the board
/fpga/CT.D22: R121.1; also elsewhere on the board
/fpga/CT.D23: R35.2; also elsewhere on the board
/fpga/CT.D24: R126.1; also elsewhere on the board
/fpga/CT.D25: R36.2; also elsewhere on the board
/fpga/CT.D26: R130.1; also elsewhere on the board
/fpga/CT.D27: R38.2; also elsewhere on the board
/fpga/CT.D28: R133.1; also elsewhere on the board
/fpga/CT.D29: R41.2; also elsewhere on the board
/fpga/CT.D30: R136.1; also elsewhere on the board
/fpga/CT.D31: R42.2; also elsewhere on the board
/fpga/CT.DTKCMB_N: R72.1; also elsewhere on the board
/fpga/CT.I6_N: R77.1; also elsewhere on the board
/fpga/CT.RST_N: R75.1; also elsewhere on the board
/fpga/CT.RW: R62.1; also elsewhere on the board
/fpga/CT.SIZ0: R66.1; also elsewhere on the board
/fpga/CT.SIZ1: R65.2; also elsewhere on the board
/fpga/CT.TA_N: R68.1; also elsewhere on the board
/fpga/CT.TEA_N: R69.2; also elsewhere on the board
/fpga/CT.TM0: R56.1; also elsewhere on the board
/fpga/CT.TM1: R61.1; also elsewhere on the board
/fpga/CT.TM2: R64.1; also elsewhere on the board
/fpga/CT.TS_N: R59.1; also elsewhere on the board
/fpga/CT.TT0: R67.1; also elsewhere on the board
/fpga/CT.TT1: R8.2; also elsewhere on the board
/fpga/FALCON_AUDIOLV.I0: U7.2 (A1); also elsewhere on the board
/fpga/FALCON_AUDIOLV.I1: U7.3 (A2); also elsewhere on the board
/fpga/FALCON_AUDIOLV.I2: U7.4 (A3); also elsewhere on the board
/fpga/FALCON_AUDIOLV.O: U7.5 (A4); also elsewhere on the board
/fpga/VIDEL33.CLK0: U5.7 (1Y); also elsewhere on the board
/fpga/VIDEL33.CLK1: U5.5 (2Y); also elsewhere on the board
/fpga/VIDEL33.CLK2: U5.2 (3Y); also elsewhere on the board
GND: C20.2, C77.2, C78.2, J1.1, J1.3, J1.5, J1.7, J1.9, J1.11, J1.13, J5.1, J5.2, J5.49, J5.50, J6.1, J6.2, J6.16, J6.49, J6.50, U5.4 (GND), U7.7 (GND), U7.15 (EP); also elsewhere on the board
unnamed: J1.2, U5.1 (1A)
unnamed: J1.4, U5.3 (2A)
unnamed: J1.6, U5.6 (3A)
unnamed: J1.8, U7.13 (B1)
unnamed: J1.10, U7.12 (B2)
unnamed: J1.12, U7.11 (B3)
unnamed: J1.14, U7.10 (B4)
unnamed: J5.3, R56.2
unnamed: J5.5, R61.2
unnamed: J5.7, R64.2
unnamed: J5.9, R67.2
unnamed: J5.10, R8.1
unnamed: J5.11, R70.2
unnamed: J5.12, R9.1
unnamed: J5.13, R73.2
unnamed: J5.14, R10.1
unnamed: J5.15, R77.2
unnamed: J5.17, R80.2
unnamed: J5.18, R11.1
unnamed: J5.19, R84.2
unnamed: J5.20, R20.1
unnamed: J5.21, R87.2
unnamed: J5.22, R19.1
unnamed: J5.23, R91.2
unnamed: J5.24, R18.1
unnamed: J5.25, R96.2
unnamed: J5.26, R17.1
unnamed: J5.27, R101.2
unnamed: J5.28, R21.1
unnamed: J5.29, R104.2
unnamed: J5.30, R23.1
unnamed: J5.31, R105.2
unnamed: J5.32, R24.1
unnamed: J5.33, R111.2
unnamed: J5.34, R26.1
unnamed: J5.35, R115.2
unnamed: J5.36, R28.1
unnamed: J5.37, R118.2
unnamed: J5.38, R33.1
unnamed: J5.39, R121.2
unnamed: J5.40, R35.1
unnamed: J5.41, R126.2
unnamed: J5.42, R36.1
unnamed: J5.43, R130.2
unnamed: J5.44, R38.1
unnamed: J5.45, R133.2
unnamed: J5.46, R41.1
unnamed: J5.47, R136.2
unnamed: J5.48, R42.1
unnamed: J6.4, R57.1
unnamed: J6.5, R59.2
unnamed: J6.6, R60.1
unnamed: J6.7, R62.2
unnamed: J6.8, R63.1
unnamed: J6.9, R66.2
unnamed: J6.10, R65.1
unnamed: J6.11, R68.2
unnamed: J6.12, R69.1
unnamed: J6.13, R72.2
unnamed: J6.14, R74.1
unnamed: J6.15, R75.2
unnamed: J6.17, R78.2
unnamed: J6.18, R79.1
unnamed: J6.19, R82.2
unnamed: J6.20, R83.1
unnamed: J6.21, R85.2
unnamed: J6.22, R86.1
unnamed: J6.23, R89.2
unnamed: J6.24, R90.1
unnamed: J6.25, R95.2
unnamed: J6.26, R97.1
unnamed: J6.27, R100.2
unnamed: J6.28, R99.1
unnamed: J6.29, R103.2
unnamed: J6.30, R102.1
unnamed: J6.31, R106.2
unnamed: J6.32, R107.1
unnamed: J6.33, R109.2
unnamed: J6.34, R110.1
unnamed: J6.35, R112.2
unnamed: J6.36, R114.1
unnamed: J6.37, R116.2
unnamed: J6.38, R117.1
unnamed: J6.39, R119.2
unnamed: J6.40, R120.1
unnamed: J6.41, R125.2
unnamed: J6.42, R124.1
unnamed: J6.43, R129.2
unnamed: J6.44, R128.1
unnamed: J6.45, R132.2
unnamed: J6.46, R131.1
unnamed: J6.47, R135.2
unnamed: J6.48, R134.1

Notes on the sheet:
To falcon expansion - 2 x 50 pin
Pins are positioned here to visually match the manual (ignore numbers!)

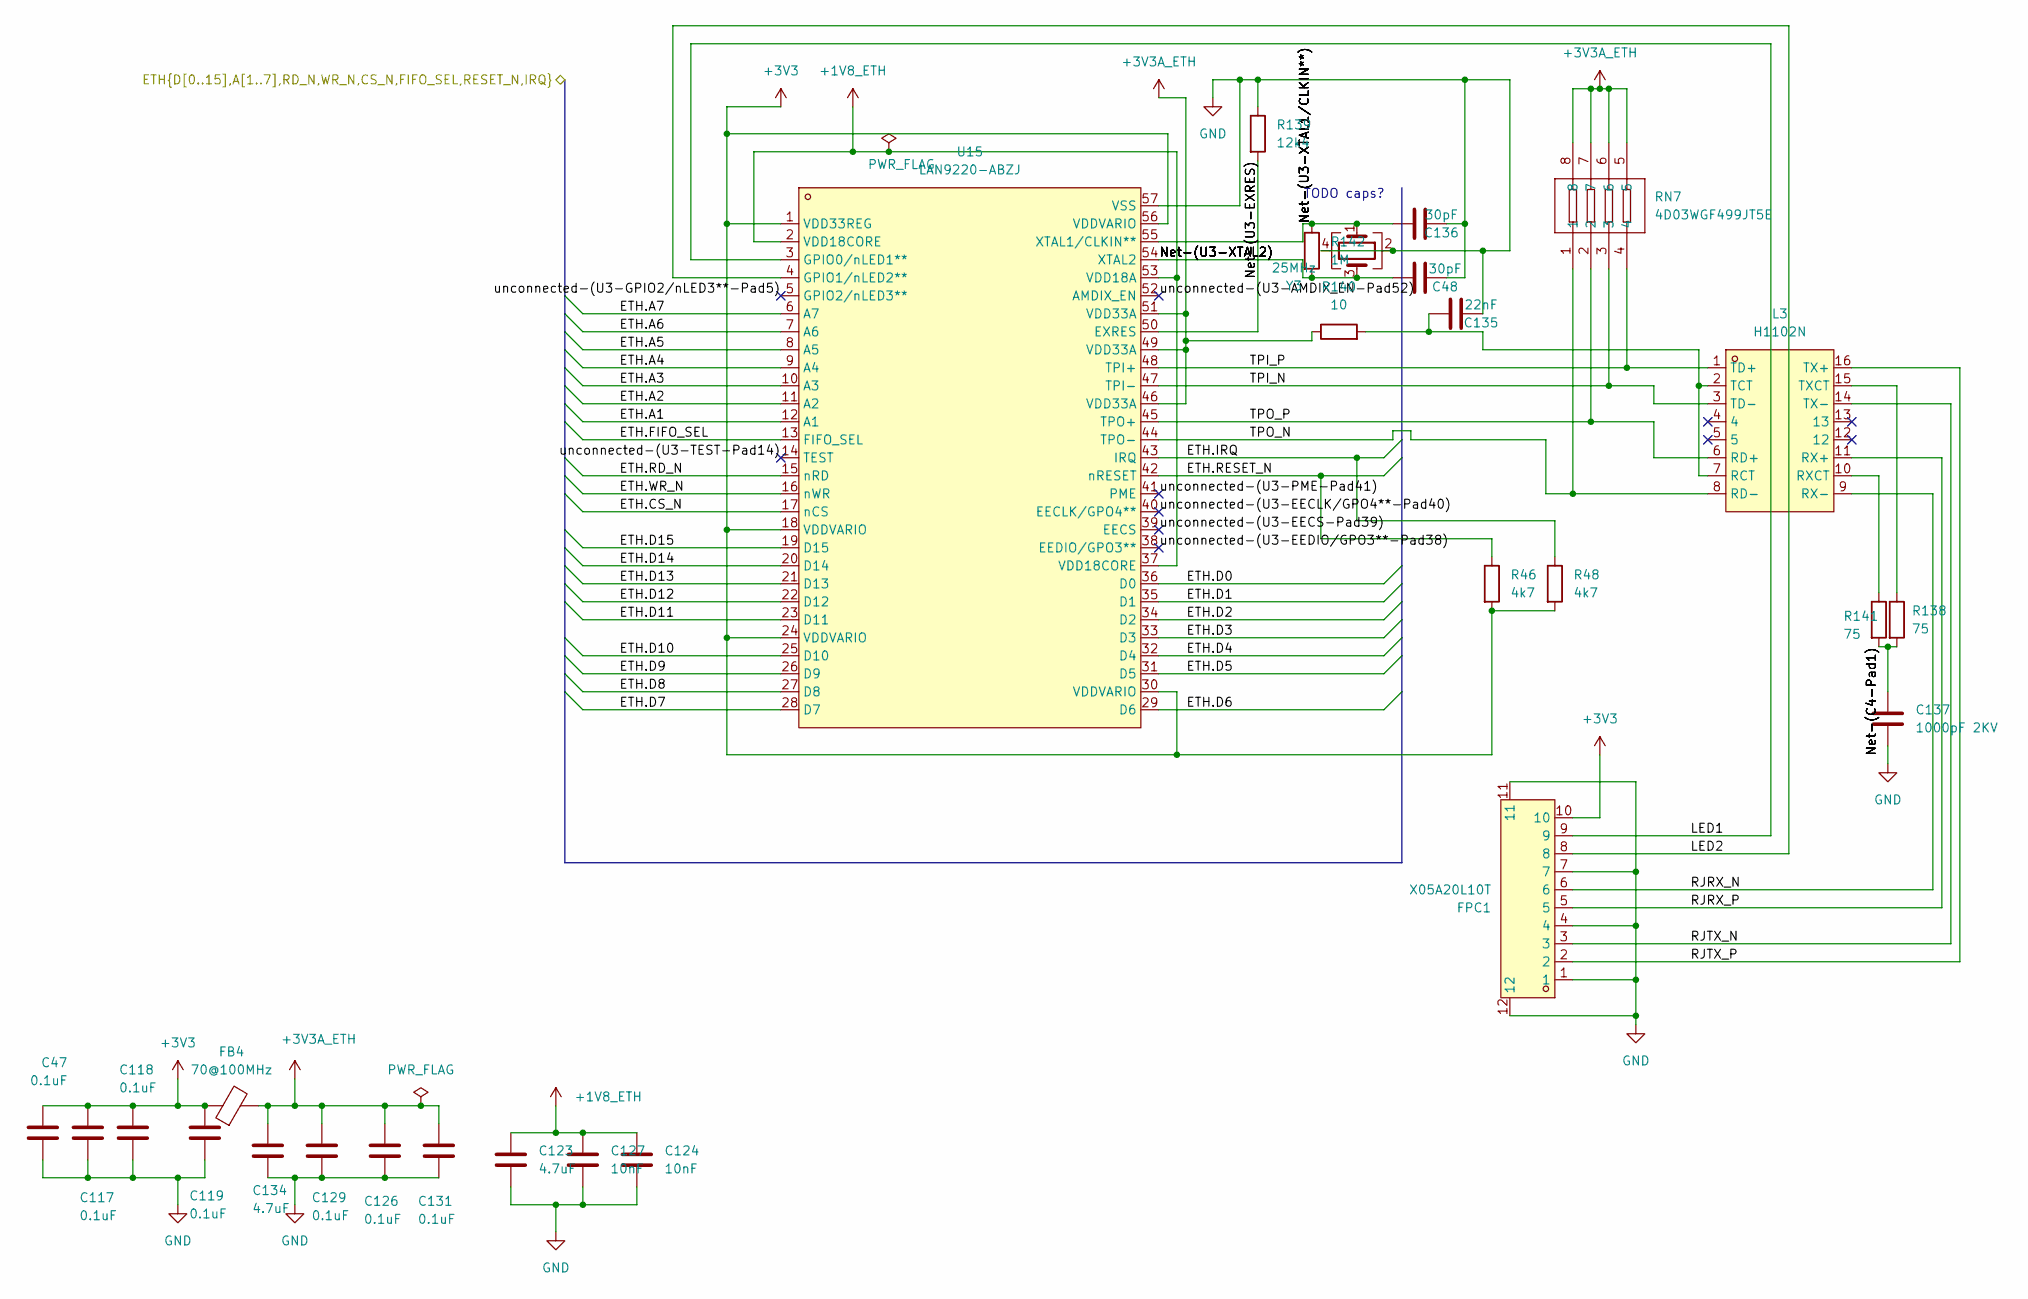
[picture p10: schematic ethernet.kicad_sch]

Parts:
C47, C117, C118, C119, C126, C129, C131: 0.1uF; C_0402_1005Metric; LCSC C1525
C48, C136: 30pF; C_0603_1608Metric; LCSC C1658
C123, C134: 4.7uF; C_0805_2012Metric; LCSC C1779
C124, C127: 10nF; C_0402_1005Metric; LCSC C15195
C135: 22nF; C_0603_1608Metric; LCSC C21122
C137: 1000pF 2KV; C_1206_3216Metric; LCSC C9196
FB4: 70@100MHz; L_0805_2012Metric; LCSC C85840
FPC1: X05A20L10T; FFC-SMD_10P-P0.50_X05A20L10T; MPN X05A20L10T; LCSC Part C388667
L3: H1102N; XFMR-SMD_H1102N; MPN H1102N; LCSC Part C42418465
R46, R48: 4k7; R_0603_1608Metric; LCSC C23162
R138, R141: 75; R_0603_1608Metric; LCSC C4275
R139: 12k4; R_0603_1608Metric; LCSC C137798
R140: 10; R_0603_1608Metric; LCSC C22859
R142: 1M; R_0603_1608Metric; LCSC C22935
RN7: 4D03WGF499JT5E; RES-ARRAY-SMD_0603-8P-L3.2-W1.6-BL; MPN 4D03WGF499JT5E; LCSC Part C54832
U15: LAN9220-ABZJ; QFN-56_L8.0-W8.0-P0.50-BL-EP6.0; MPN LAN9220-ABZJ; LCSC Part C1521597
Y3: 25MHz; Crystal_SMD_3225-4Pin_3.2x2.5mm; LCSC C5308007

Connections:
+1V8_ETH: C123.1, C124.1, C127.1, U15.2 (VDD18CORE), U15.37 (VDD18CORE), U15.53 (VDD18A)
+3V3: C47.1, C117.1, C118.1, C119.1, FB4.1, FPC1.10, R46.2, R48.2, U15.1 (VDD33REG), U15.18 (VDDVARIO), U15.24 (VDDVARIO), U15.30 (VDDVARIO), U15.56 (VDDVARIO); also elsewhere on the board
+3V3A_ETH: C126.1, C129.1, C131.1, C134.1, FB4.2, R140.1, RN7.5, RN7.6, RN7.7, RN7.8, U15.46 (VDD33A), U15.49 (VDD33A), U15.51 (VDD33A)
/Ethernet/LED1: FPC1.9, U15.3 (GPIO0/nLED1**)
/Ethernet/LED2: FPC1.8, U15.4 (GPIO1/nLED2**)
/Ethernet/Net-(C4-Pad1): C137.1, R138.2, R141.2
/Ethernet/Net-(U3-EXRES): R139.2, U15.50 (EXRES)
/Ethernet/Net-(U3-XTAL1/CLKIN**): C136.2, R142.1, U15.55 (XTAL1/CLKIN**), Y3.1
/Ethernet/Net-(U3-XTAL2): C48.2, R142.2, U15.54 (XTAL2), Y3.3
/Ethernet/RJRX_N: FPC1.6, L3.9 (RX-)
/Ethernet/RJRX_P: FPC1.5, L3.11 (RX+)
/Ethernet/RJTX_N: FPC1.3, L3.14 (TX-)
/Ethernet/RJTX_P: FPC1.2, L3.16 (TX+)
/Ethernet/TPI_N: L3.3 (TD-), RN7.3, U15.47 (TPI-)
/Ethernet/TPI_P: L3.1 (TD+), RN7.4, U15.48 (TPI+)
/Ethernet/TPO_N: L3.8 (RD-), RN7.1, U15.44 (TPO-)
/Ethernet/TPO_P: L3.6 (RD+), RN7.2, U15.45 (TPO+)
/Ethernet/unconnected-(U3-AMDIX_EN-Pad52): U15.52 (AMDIX_EN)
/Ethernet/unconnected-(U3-EECLK/GPO4**-Pad40): U15.40 (EECLK/GPO4**)
/Ethernet/unconnected-(U3-EECS-Pad39): U15.39 (EECS)
/Ethernet/unconnected-(U3-EEDIO/GPO3**-Pad38): U15.38 (EEDIO/GPO3**)
/Ethernet/unconnected-(U3-GPIO2/nLED3**-Pad5): U15.5 (GPIO2/nLED3**)
/Ethernet/unconnected-(U3-PME-Pad41): U15.41 (PME)
/Ethernet/unconnected-(U3-TEST-Pad14): U15.14 (TEST)
/fpga/ETH.A1: U15.12 (A1); also elsewhere on the board
/fpga/ETH.A2: U15.11 (A2); also elsewhere on the board
/fpga/ETH.A3: U15.10 (A3); also elsewhere on the board
/fpga/ETH.A4: U15.9 (A4); also elsewhere on the board
/fpga/ETH.A5: U15.8 (A5); also elsewhere on the board
/fpga/ETH.A6: U15.7 (A6); also elsewhere on the board
/fpga/ETH.A7: U15.6 (A7); also elsewhere on the board
/fpga/ETH.CS_N: U15.17 (nCS); also elsewhere on the board
/fpga/ETH.D0: U15.36 (D0); also elsewhere on the board
/fpga/ETH.D1: U15.35 (D1); also elsewhere on the board
/fpga/ETH.D2: U15.34 (D2); also elsewhere on the board
/fpga/ETH.D3: U15.33 (D3); also elsewhere on the board
/fpga/ETH.D4: U15.32 (D4); also elsewhere on the board
/fpga/ETH.D5: U15.31 (D5); also elsewhere on the board
/fpga/ETH.D6: U15.29 (D6); also elsewhere on the board
/fpga/ETH.D7: U15.28 (D7); also elsewhere on the board
/fpga/ETH.D8: U15.27 (D8); also elsewhere on the board
/fpga/ETH.D9: U15.26 (D9); also elsewhere on the board
/fpga/ETH.D10: U15.25 (D10); also elsewhere on the board
/fpga/ETH.D11: U15.23 (D11); also elsewhere on the board
/fpga/ETH.D12: U15.22 (D12); also elsewhere on the board
/fpga/ETH.D13: U15.21 (D13); also elsewhere on the board
/fpga/ETH.D14: U15.20 (D14); also elsewhere on the board
/fpga/ETH.D15: U15.19 (D15); also elsewhere on the board
/fpga/ETH.FIFO_SEL: U15.13 (FIFO_SEL); also elsewhere on the board
/fpga/ETH.IRQ: R48.1, U15.43 (IRQ); also elsewhere on the board
/fpga/ETH.RD_N: U15.15 (nRD); also elsewhere on the board
/fpga/ETH.RESET_N: R46.1, U15.42 (nRESET); also elsewhere on the board
/fpga/ETH.WR_N: U15.16 (nWR); also elsewhere on the board
GND: C47.2, C48.1, C117.2, C118.2, C119.2, C123.2, C124.2, C126.2, C127.2, C129.2, C131.2, C134.2, C135.1, C136.1, C137.2, FPC1.1, FPC1.4, FPC1.7, FPC1.11, FPC1.12, R139.1, U15.57 (VSS), Y3.2, Y3.4; also elsewhere on the board
unnamed: C135.2, L3.2 (TCT), L3.7 (RCT), R140.2
unnamed: L3.10 (RXCT), R141.1
unnamed: L3.15 (TXCT), R138.1

Notes on the sheet:
TODO caps?
