scrameta/mega_videl/board/kicad/mega_videl/mega_videl.kicad_pcb

## KiCad design board/kicad/mega_videl/mega_videl.kicad_pcb (continued)

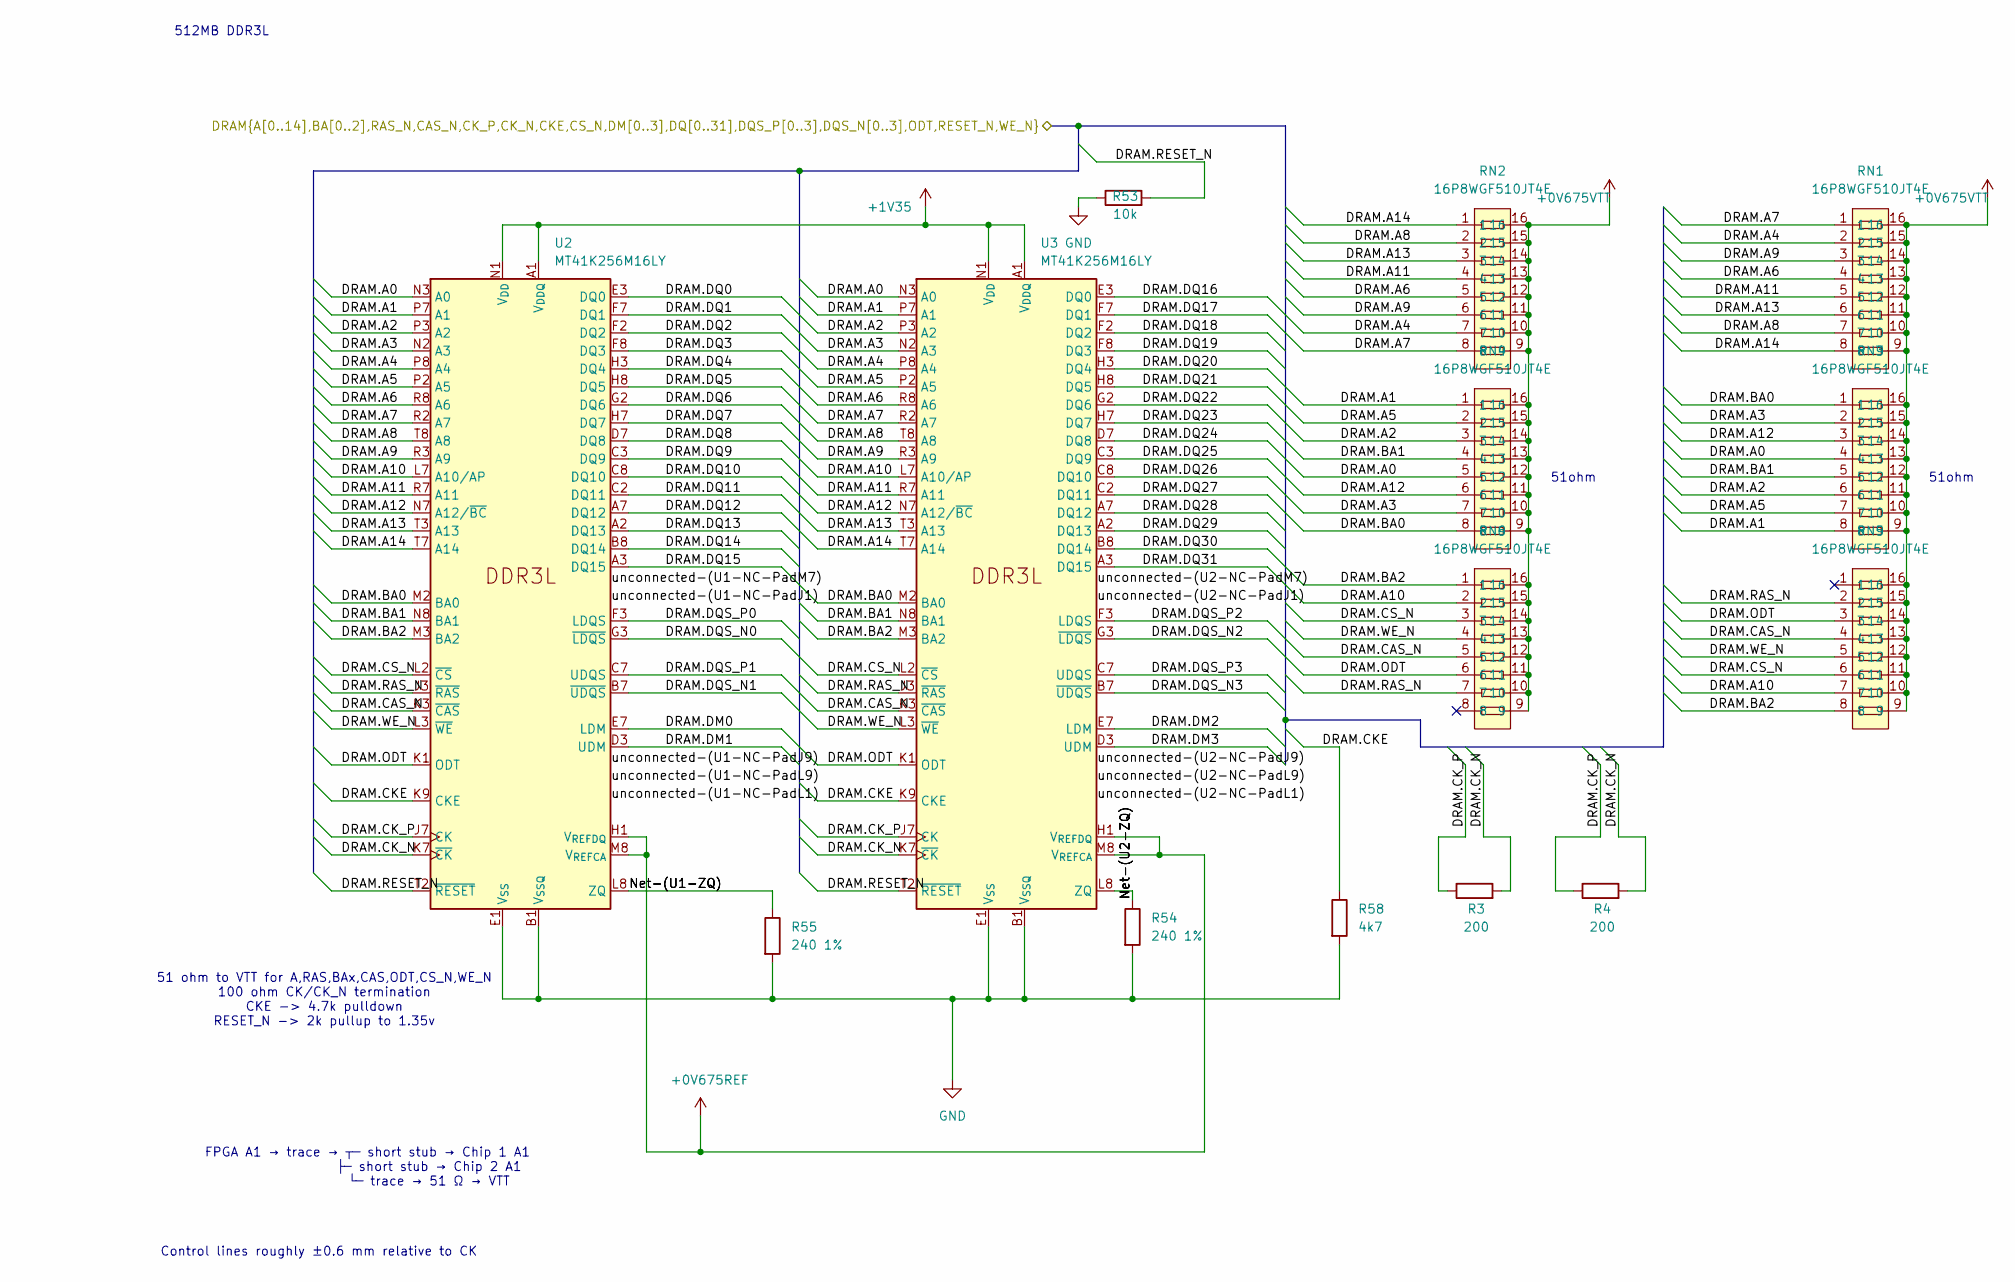
[picture p11: schematic ddr3.kicad_sch]

Parts:
R3, R4: 200; R_0402_1005Metric; LCSC C25087
R53: 10k; R_0603_1608Metric; LCSC C25804
R54, R55: 240 1%; R_0603_1608Metric; LCSC C23350
R58: 4k7; R_0603_1608Metric; LCSC C23162
RN1, RN2, RN3, RN4, RN5, RN6: 16P8WGF510JT4E; RES-ARRAY-SMD_0402-16P-L4.0-W1.6-BL-1; MPN 16P8WGF510JT4E; LCSC Part C422180
U2, U3: MT41K256M16LY; FBGA-96_L13.5-W7.5-P0.80-TL_MT41J256M16LY-091G; LCSC Part C253882

Connections:
+0V675REF: U2.H1 (V_{REFDQ}), U2.M8 (V_{REFCA}), U3.H1 (V_{REFDQ}), U3.M8 (V_{REFCA}); also elsewhere on the board
+0V675VTT: RN1.9, RN1.10, RN1.11, RN1.12, RN1.13, RN1.14, RN1.15, RN1.16, RN2.9, RN2.10, RN2.11, RN2.12, RN2.13, RN2.14, RN2.15, RN2.16, RN3.9, RN3.10, RN3.11, RN3.12, RN3.13, RN3.14, RN3.15, RN3.16, RN4.9, RN4.10, RN4.11, RN4.12, RN4.13, RN4.14, RN4.15, RN4.16, RN5.9, RN5.10, RN5.11, RN5.12, RN5.13, RN5.14, RN5.15, RN5.16, RN6.9, RN6.10, RN6.11, RN6.12, RN6.13, RN6.14, RN6.15, RN6.16; also elsewhere on the board
+1V35: U2.A1 (V_{DDQ}), U2.A8 (V_{DDQ}), U2.B2 (V_{DD}), U2.C1 (V_{DDQ}), U2.C9 (V_{DDQ}), U2.D2 (V_{DDQ}), U2.D9 (V_{DD}), U2.E9 (V_{DDQ}), U2.F1 (V_{DDQ}), U2.G7 (V_{DD}), U2.H2 (V_{DDQ}), U2.H9 (V_{DDQ}), U2.K2 (V_{DD}), U2.K8 (V_{DD}), U2.N1 (V_{DD}), U2.N9 (V_{DD}), U2.R1 (V_{DD}), U2.R9 (V_{DD}), U3.A1 (V_{DDQ}), U3.A8 (V_{DDQ}), U3.B2 (V_{DD}), U3.C1 (V_{DDQ}), U3.C9 (V_{DDQ}), U3.D2 (V_{DDQ}), U3.D9 (V_{DD}), U3.E9 (V_{DDQ}), U3.F1 (V_{DDQ}), U3.G7 (V_{DD}), U3.H2 (V_{DDQ}), U3.H9 (V_{DDQ}), U3.K2 (V_{DD}), U3.K8 (V_{DD}), U3.N1 (V_{DD}), U3.N9 (V_{DD}), U3.R1 (V_{DD}), U3.R9 (V_{DD}); also elsewhere on the board
/ddr3/Net-(U1-ZQ): R55.1, U2.L8 (ZQ)
/ddr3/Net-(U2-ZQ): R54.1, U3.L8 (ZQ)
/fpga/DRAM.A0: RN3.4, RN4.5, U2.N3 (A0), U3.N3 (A0); also elsewhere on the board
/fpga/DRAM.A1: RN3.8, RN4.1, U2.P7 (A1), U3.P7 (A1); also elsewhere on the board
/fpga/DRAM.A2: RN3.6, RN4.3, U2.P3 (A2), U3.P3 (A2); also elsewhere on the board
/fpga/DRAM.A3: RN3.2, RN4.7, U2.N2 (A3), U3.N2 (A3); also elsewhere on the board
/fpga/DRAM.A4: RN1.2, RN2.7, U2.P8 (A4), U3.P8 (A4); also elsewhere on the board
/fpga/DRAM.A5: RN3.7, RN4.2, U2.P2 (A5), U3.P2 (A5); also elsewhere on the board
/fpga/DRAM.A6: RN1.4, RN2.5, U2.R8 (A6), U3.R8 (A6); also elsewhere on the board
/fpga/DRAM.A7: RN1.1, RN2.8, U2.R2 (A7), U3.R2 (A7); also elsewhere on the board
/fpga/DRAM.A8: RN1.7, RN2.2, U2.T8 (A8), U3.T8 (A8); also elsewhere on the board
/fpga/DRAM.A9: RN1.3, RN2.6, U2.R3 (A9), U3.R3 (A9); also elsewhere on the board
/fpga/DRAM.A10: RN5.7, RN6.2, U2.L7 (A10/AP), U3.L7 (A10/AP); also elsewhere on the board
/fpga/DRAM.A11: RN1.5, RN2.4, U2.R7 (A11), U3.R7 (A11); also elsewhere on the board
/fpga/DRAM.A12: RN3.3, RN4.6, U2.N7 (A12/~BC), U3.N7 (A12/~BC); also elsewhere on the board
/fpga/DRAM.A13: RN1.6, RN2.3, U2.T3 (A13), U3.T3 (A13); also elsewhere on the board
/fpga/DRAM.A14: RN1.8, RN2.1, U2.T7 (A14), U3.T7 (A14); also elsewhere on the board
/fpga/DRAM.BA0: RN3.1, RN4.8, U2.M2 (BA0), U3.M2 (BA0); also elsewhere on the board
/fpga/DRAM.BA1: RN3.5, RN4.4, U2.N8 (BA1), U3.N8 (BA1); also elsewhere on the board
/fpga/DRAM.BA2: RN5.8, RN6.1, U2.M3 (BA2), U3.M3 (BA2); also elsewhere on the board
/fpga/DRAM.CAS_N: RN5.4, RN6.5, U2.K3 (~CAS), U3.K3 (~CAS); also elsewhere on the board
/fpga/DRAM.CKE: R58.1, U2.K9 (CKE), U3.K9 (CKE); also elsewhere on the board
/fpga/DRAM.CK_N: R3.2, R4.2, U2.K7 (~CK), U3.K7 (~CK); also elsewhere on the board
/fpga/DRAM.CK_P: R3.1, R4.1, U2.J7 (CK), U3.J7 (CK); also elsewhere on the board
/fpga/DRAM.CS_N: RN5.6, RN6.3, U2.L2 (~CS), U3.L2 (~CS); also elsewhere on the board
/fpga/DRAM.DM0: U2.E7 (LDM); also elsewhere on the board
/fpga/DRAM.DM1: U2.D3 (UDM); also elsewhere on the board
/fpga/DRAM.DM2: U3.E7 (LDM); also elsewhere on the board
/fpga/DRAM.DM3: U3.D3 (UDM); also elsewhere on the board
/fpga/DRAM.DQ0: U2.E3 (DQ0); also elsewhere on the board
/fpga/DRAM.DQ1: U2.F7 (DQ1); also elsewhere on the board
/fpga/DRAM.DQ2: U2.F2 (DQ2); also elsewhere on the board
/fpga/DRAM.DQ3: U2.F8 (DQ3); also elsewhere on the board
/fpga/DRAM.DQ4: U2.H3 (DQ4); also elsewhere on the board
/fpga/DRAM.DQ5: U2.H8 (DQ5); also elsewhere on the board
/fpga/DRAM.DQ6: U2.G2 (DQ6); also elsewhere on the board
/fpga/DRAM.DQ7: U2.H7 (DQ7); also elsewhere on the board
/fpga/DRAM.DQ8: U2.D7 (DQ8); also elsewhere on the board
/fpga/DRAM.DQ9: U2.C3 (DQ9); also elsewhere on the board
/fpga/DRAM.DQ10: U2.C8 (DQ10); also elsewhere on the board
/fpga/DRAM.DQ11: U2.C2 (DQ11); also elsewhere on the board
/fpga/DRAM.DQ12: U2.A7 (DQ12); also elsewhere on the board
/fpga/DRAM.DQ13: U2.A2 (DQ13); also elsewhere on the board
/fpga/DRAM.DQ14: U2.B8 (DQ14); also elsewhere on the board
/fpga/DRAM.DQ15: U2.A3 (DQ15); also elsewhere on the board
/fpga/DRAM.DQ16: U3.E3 (DQ0); also elsewhere on the board
/fpga/DRAM.DQ17: U3.F7 (DQ1); also elsewhere on the board
/fpga/DRAM.DQ18: U3.F2 (DQ2); also elsewhere on the board
/fpga/DRAM.DQ19: U3.F8 (DQ3); also elsewhere on the board
/fpga/DRAM.DQ20: U3.H3 (DQ4); also elsewhere on the board
/fpga/DRAM.DQ21: U3.H8 (DQ5); also elsewhere on the board
/fpga/DRAM.DQ22: U3.G2 (DQ6); also elsewhere on the board
/fpga/DRAM.DQ23: U3.H7 (DQ7); also elsewhere on the board
/fpga/DRAM.DQ24: U3.D7 (DQ8); also elsewhere on the board
/fpga/DRAM.DQ25: U3.C3 (DQ9); also elsewhere on the board
/fpga/DRAM.DQ26: U3.C8 (DQ10); also elsewhere on the board
/fpga/DRAM.DQ27: U3.C2 (DQ11); also elsewhere on the board
/fpga/DRAM.DQ28: U3.A7 (DQ12); also elsewhere on the board
/fpga/DRAM.DQ29: U3.A2 (DQ13); also elsewhere on the board
/fpga/DRAM.DQ30: U3.B8 (DQ14); also elsewhere on the board
/fpga/DRAM.DQ31: U3.A3 (DQ15); also elsewhere on the board
/fpga/DRAM.DQS_N0: U2.G3 (~LDQS); also elsewhere on the board
/fpga/DRAM.DQS_N1: U2.B7 (~UDQS); also elsewhere on the board
/fpga/DRAM.DQS_N2: U3.G3 (~LDQS); also elsewhere on the board
/fpga/DRAM.DQS_N3: U3.B7 (~UDQS); also elsewhere on the board
/fpga/DRAM.DQS_P0: U2.F3 (LDQS); also elsewhere on the board
/fpga/DRAM.DQS_P1: U2.C7 (UDQS); also elsewhere on the board
/fpga/DRAM.DQS_P2: U3.F3 (LDQS); also elsewhere on the board
/fpga/DRAM.DQS_P3: U3.C7 (UDQS); also elsewhere on the board
/fpga/DRAM.ODT: RN5.3, RN6.6, U2.K1 (ODT), U3.K1 (ODT); also elsewhere on the board
/fpga/DRAM.RAS_N: RN5.2, RN6.7, U2.J3 (~RAS), U3.J3 (~RAS); also elsewhere on the board
/fpga/DRAM.RESET_N: R53.2, U2.T2 (~RESET), U3.T2 (~RESET); also elsewhere on the board
/fpga/DRAM.WE_N: RN5.5, RN6.4, U2.L3 (~WE), U3.L3 (~WE); also elsewhere on the board
GND: R53.1, R54.2, R55.2, R58.2, U2.A9 (V_{SS}), U2.B1 (V_{SSQ}), U2.B3 (V_{SS}), U2.B9 (V_{SSQ}), U2.D1 (V_{SSQ}), U2.D8 (V_{SSQ}), U2.E1 (V_{SS}), U2.E2 (V_{SSQ}), U2.E8 (V_{SSQ}), U2.F9 (V_{SSQ}), U2.G1 (V_{SSQ}), U2.G8 (V_{SS}), U2.G9 (V_{SSQ}), U2.J2 (V_{SS}), U2.J8 (V_{SS}), U2.M1 (V_{SS}), U2.M9 (V_{SS}), U2.P1 (V_{SS}), U2.P9 (V_{SS}), U2.T1 (V_{SS}), U2.T9 (V_{SS}), U3.A9 (V_{SS}), U3.B1 (V_{SSQ}), U3.B3 (V_{SS}), U3.B9 (V_{SSQ}), U3.D1 (V_{SSQ}), U3.D8 (V_{SSQ}), U3.E1 (V_{SS}), U3.E2 (V_{SSQ}), U3.E8 (V_{SSQ}), U3.F9 (V_{SSQ}), U3.G1 (V_{SSQ}), U3.G8 (V_{SS}), U3.G9 (V_{SSQ}), U3.J2 (V_{SS}), U3.J8 (V_{SS}), U3.M1 (V_{SS}), U3.M9 (V_{SS}), U3.P1 (V_{SS}), U3.P9 (V_{SS}), U3.T1 (V_{SS}), U3.T9 (V_{SS}); also elsewhere on the board

Notes on the sheet:
51ohm
512MB DDR3L
Control lines roughly ±0.6 mm relative to CK
FPGA A1 → trace → ┬─ short stub → Chip 1 A1 ├─ short stub → Chip 2 A1 └─ trace → 51 Ω → VTT
51 ohm to VTT for A,RAS,BAx,CAS,ODT,CS_N,WE_N 100 ohm CK/CK_N termination CKE -> 4.7k pulldown RESET_N -> 2k pullup to 1.35v

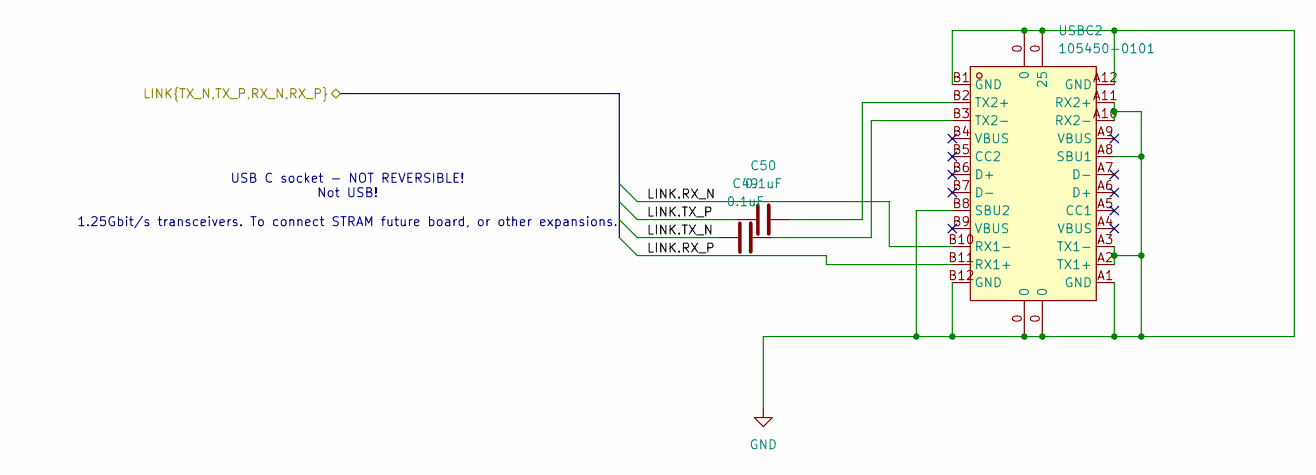
[picture p12: schematic stram.kicad_sch]

Parts:
C49, C50: 0.1uF; C_0603_1608Metric; LCSC C14663
USBC2: 105450-0101; USB-C-SMD_TYPE-C-USB-18; MPN 1054500101; LCSC Part C134092

Connections:
/fpga/LINK.RX_N: USBC2.B10 (RX1-); also elsewhere on the board
/fpga/LINK.RX_P: USBC2.B11 (RX1+); also elsewhere on the board
/fpga/LINK.TX_N: C49.1; also elsewhere on the board
/fpga/LINK.TX_P: C50.1; also elsewhere on the board
GND: USBC2.0, USBC2.A1 (GND), USBC2.A2 (TX1+), USBC2.A3 (TX1-), USBC2.A8 (SBU1), USBC2.A10 (RX2-), USBC2.A11 (RX2+), USBC2.A12 (GND), USBC2.B1 (GND), USBC2.B8 (SBU2), USBC2.B12 (GND); also elsewhere on the board
unnamed: C50.2, USBC2.B2 (TX2+)
unnamed: C49.2, USBC2.B3 (TX2-)

Notes on the sheet:
USB C socket - NOT REVERSIBLE! Not USB! 1.25Gbit/s transceivers. To connect STRAM future board, or other expansions.

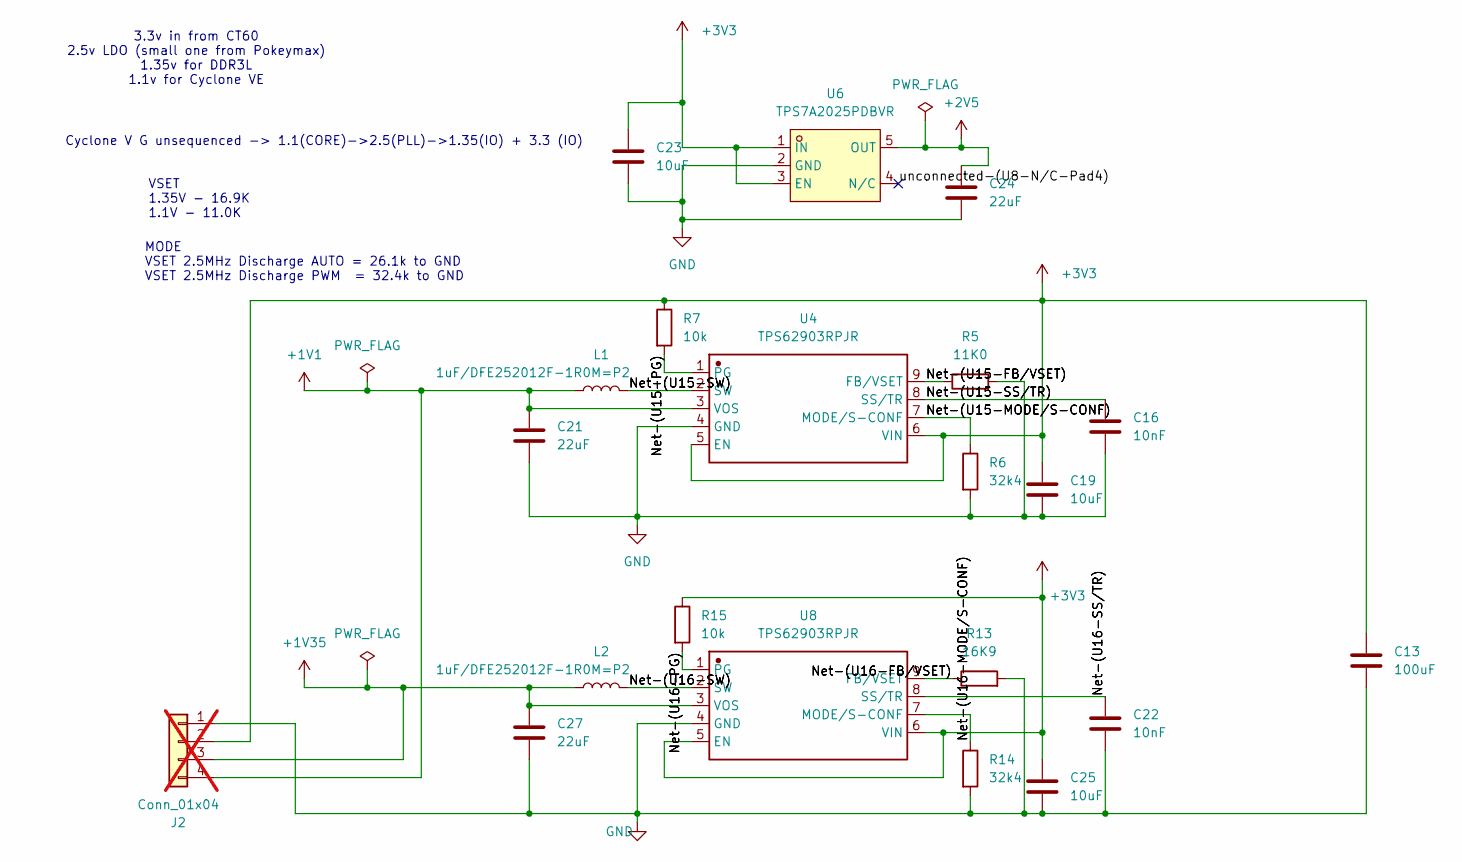
[picture p13: schematic power.kicad_sch]

Parts:
C13: 100uF; C_1206_3216Metric; LCSC C7432784
C16, C22: 10nF; C_0402_1005Metric; LCSC C15195
C19, C23, C25: 10uF; C_0805_2012Metric; LCSC C15850
C21, C24, C27: 22uF; C_0805_2012Metric; LCSC C45783
J2: Conn_01x04; PinHeader_1x04_P2.54mm_Vertical; not fitted
L1, L2: 1uF/DFE252012F-1R0M=P2; L_1008_2520Metric; LCSC C435392
R5: 11K0; R_0603_1608Metric; LCSC C25950
R6, R14: 32k4; R_0603_1608Metric; LCSC C13187
R7, R15: 10k; R_0603_1608Metric; LCSC C25804
R13: 16K9; R_0603_1608Metric; LCSC C25954
U4, U8: TPS62903RPJR; VQFN-HR-9_L2.0-W1.5-P0.50-TL; Manufacturer Part TPS62903RPJR; LCSC C2866502
U6: TPS7A2025PDBVR; SOT-23-5_L2.9-W1.6-P0.95-LS2.8-BR; MPN TPS7A2025PDBVR; LCSC Part C2869949

Connections:
+1V1: C21.1, J2.4, L1.1, U4.3 (VOS); also elsewhere on the board
+1V35: C27.1, J2.3, L2.1, U8.3 (VOS); also elsewhere on the board
+2V5: C24.1, U6.5 (OUT); also elsewhere on the board
+3V3: C13.1, C19.1, C23.1, C25.1, J2.2, R7.1, R15.1, U4.5 (EN), U4.6 (VIN), U6.1 (IN), U6.3 (EN), U8.5 (EN), U8.6 (VIN); also elsewhere on the board
/power/Net-(U15-FB/VSET): R5.1, U4.9 (FB/VSET)
/power/Net-(U15-MODE/S-CONF): R6.1, U4.7 (MODE/S-CONF)
/power/Net-(U15-PG): R7.2, U4.1 (PG)
/power/Net-(U15-SS/TR): C16.1, U4.8 (SS/TR)
/power/Net-(U15-SW): L1.2, U4.2 (SW)
/power/Net-(U16-FB/VSET): R13.1, U8.9 (FB/VSET)
/power/Net-(U16-MODE/S-CONF): R14.1, U8.7 (MODE/S-CONF)
/power/Net-(U16-PG): R15.2, U8.1 (PG)
/power/Net-(U16-SS/TR): C22.1, U8.8 (SS/TR)
/power/Net-(U16-SW): L2.2, U8.2 (SW)
/power/unconnected-(U8-N/C-Pad4): U6.4 (N/C)
GND: C13.2, C16.2, C19.2, C21.2, C22.2, C23.2, C24.2, C25.2, C27.2, J2.1, R5.2, R6.2, R13.2, R14.2, U4.4 (GND), U6.2 (GND), U8.4 (GND); also elsewhere on the board

Notes on the sheet:
3.3v in from CT60 2.5v LDO (small one from Pokeymax) 1.35v for DDR3L 1.1v for Cyclone VE
Cyclone V G unsequenced -> 1.1(CORE)->2.5(PLL)->1.35(IO) + 3.3 (IO)
MODE VSET 2.5MHz Discharge AUTO = 26.1k to GND VSET 2.5MHz Discharge PWM = 32.4k to GND
VSET 1.35V - 16.9K 1.1V - 11.0K

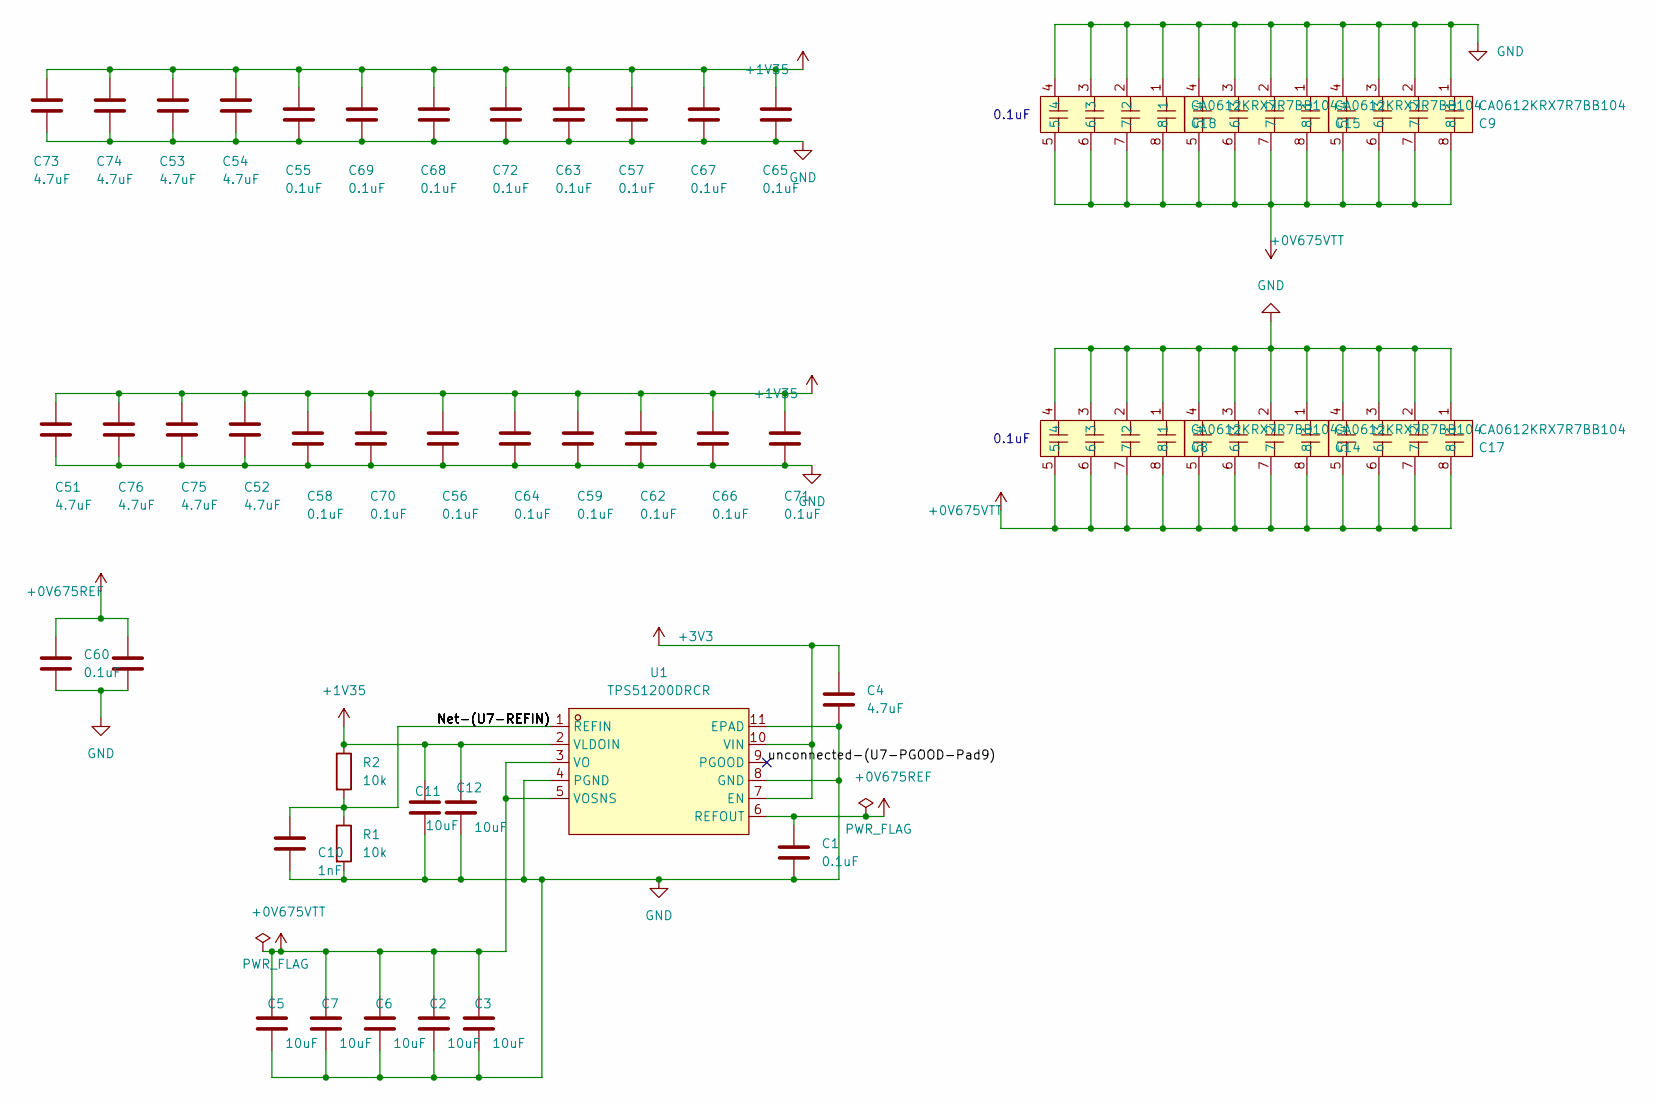
[picture p14: schematic ddr3power.kicad_sch]

Parts:
C1, C60, C61: 0.1uF; C_0603_1608Metric; LCSC C14663
C2, C3, C5, C6, C7, C11, C12: 10uF; C_0805_2012Metric; LCSC C15850
C4, C51, C52, C53, C54, C73, C74, C75, C76: 4.7uF; C_0805_2012Metric; LCSC C1779
C8, C9, C14, C15, C17, C18: CA0612KRX7R7BB104; CAP-ARRAY-SMD_0612-8P-L3.2-W1.6-BL; MPN CA0612KRX7R7BB104; LCSC Part C576639
C10: 1nF; C_0603_1608Metric; LCSC C1588
C55, C56, C57, C58, C59, C62, C63, C64, C65, C66, C67, C68, C69, C70, C71, C72: 0.1uF; C_0402_1005Metric; LCSC C1525
R1, R2: 10k; R_0603_1608Metric; LCSC C25804
U1: TPS51200DRCR; WSON-10_L3.0-W3.0-P0.50-BL-EP; MPN TPS51200DRCR; LCSC Part C34771

Connections:
+0V675REF: C1.1, C60.1, C61.1, U1.6 (REFOUT); also elsewhere on the board
+0V675VTT: C2.1, C3.1, C5.1, C6.1, C7.1, C8.5, C8.6, C8.7, C8.8, C9.5, C9.6, C9.7, C9.8, C14.5, C14.6, C14.7, C14.8, C15.5, C15.6, C15.7, C15.8, C17.5, C17.6, C17.7, C17.8, C18.5, C18.6, C18.7, C18.8, U1.3 (VO), U1.5 (VOSNS); also elsewhere on the board
+1V35: C11.1, C12.1, C51.1, C52.1, C53.1, C54.1, C55.1, C56.1, C57.1, C58.1, C59.1, C62.1, C63.1, C64.1, C65.1, C66.1, C67.1, C68.1, C69.1, C70.1, C71.1, C72.1, C73.1, C74.1, C75.1, C76.1, R2.1, U1.2 (VLDOIN); also elsewhere on the board
+3V3: C4.1, U1.7 (EN), U1.10 (VIN); also elsewhere on the board
/ddr3power/Net-(U7-REFIN): C10.1, R1.1, R2.2, U1.1 (REFIN)
/ddr3power/unconnected-(U7-PGOOD-Pad9): U1.9 (PGOOD)
GND: C1.2, C2.2, C3.2, C4.2, C5.2, C6.2, C7.2, C8.1, C8.2, C8.3, C8.4, C9.1, C9.2, C9.3, C9.4, C10.2, C11.2, C12.2, C14.1, C14.2, C14.3, C14.4, C15.1, C15.2, C15.3, C15.4, C17.1, C17.2, C17.3, C17.4, C18.1, C18.2, C18.3, C18.4, C51.2, C52.2, C53.2, C54.2, C55.2, C56.2, C57.2, C58.2, C59.2, C60.2, C61.2, C62.2, C63.2, C64.2, C65.2, C66.2, C67.2, C68.2, C69.2, C70.2, C71.2, C72.2, C73.2, C74.2, C75.2, C76.2, R1.2, U1.4 (PGND), U1.8 (GND), U1.11 (EPAD); also elsewhere on the board

Notes on the sheet:
0.1uF

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
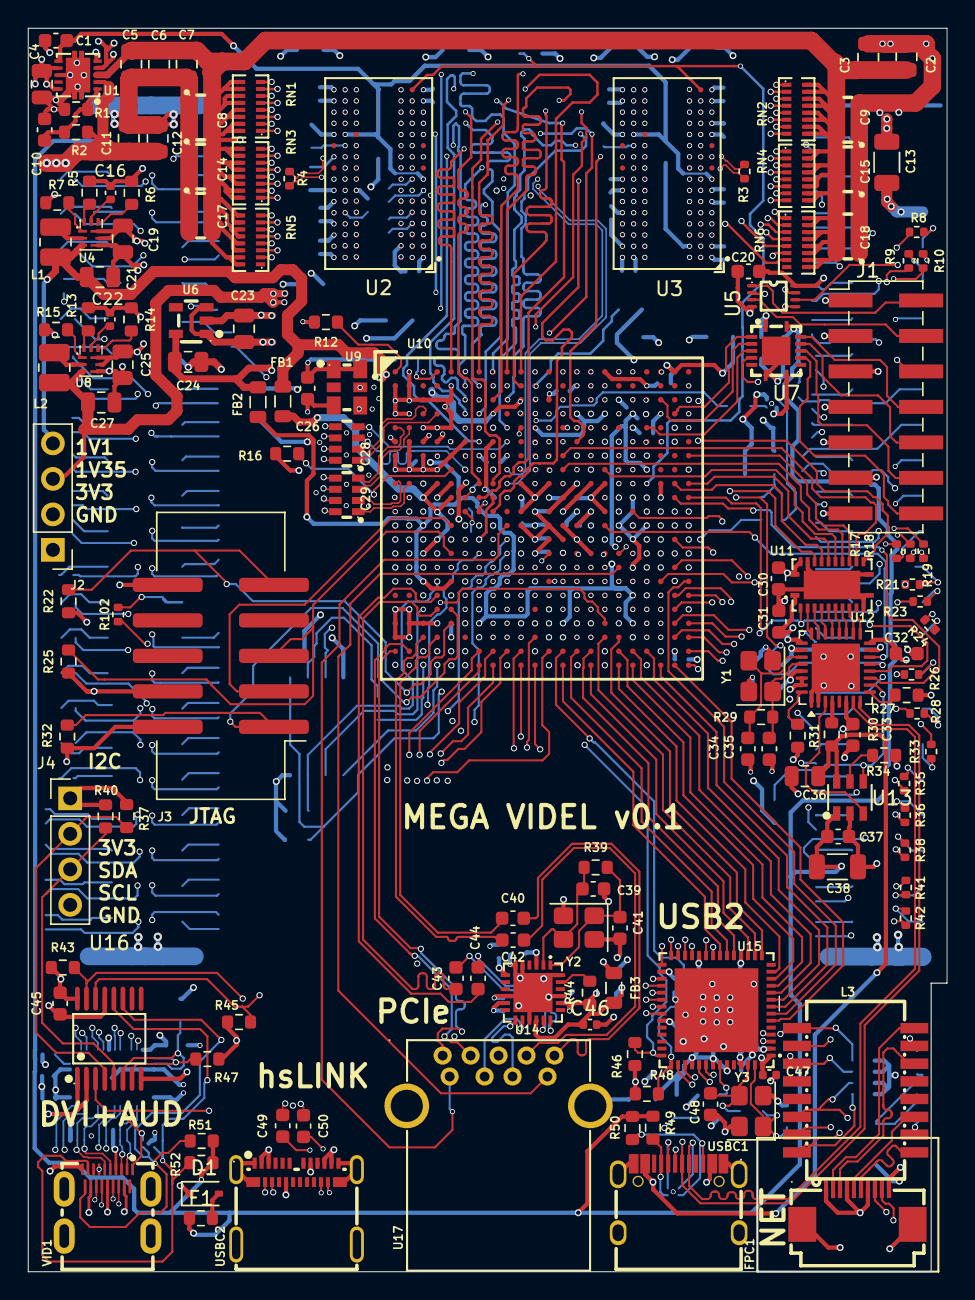
[picture p15: board mega_videl.kicad_pcb from above]

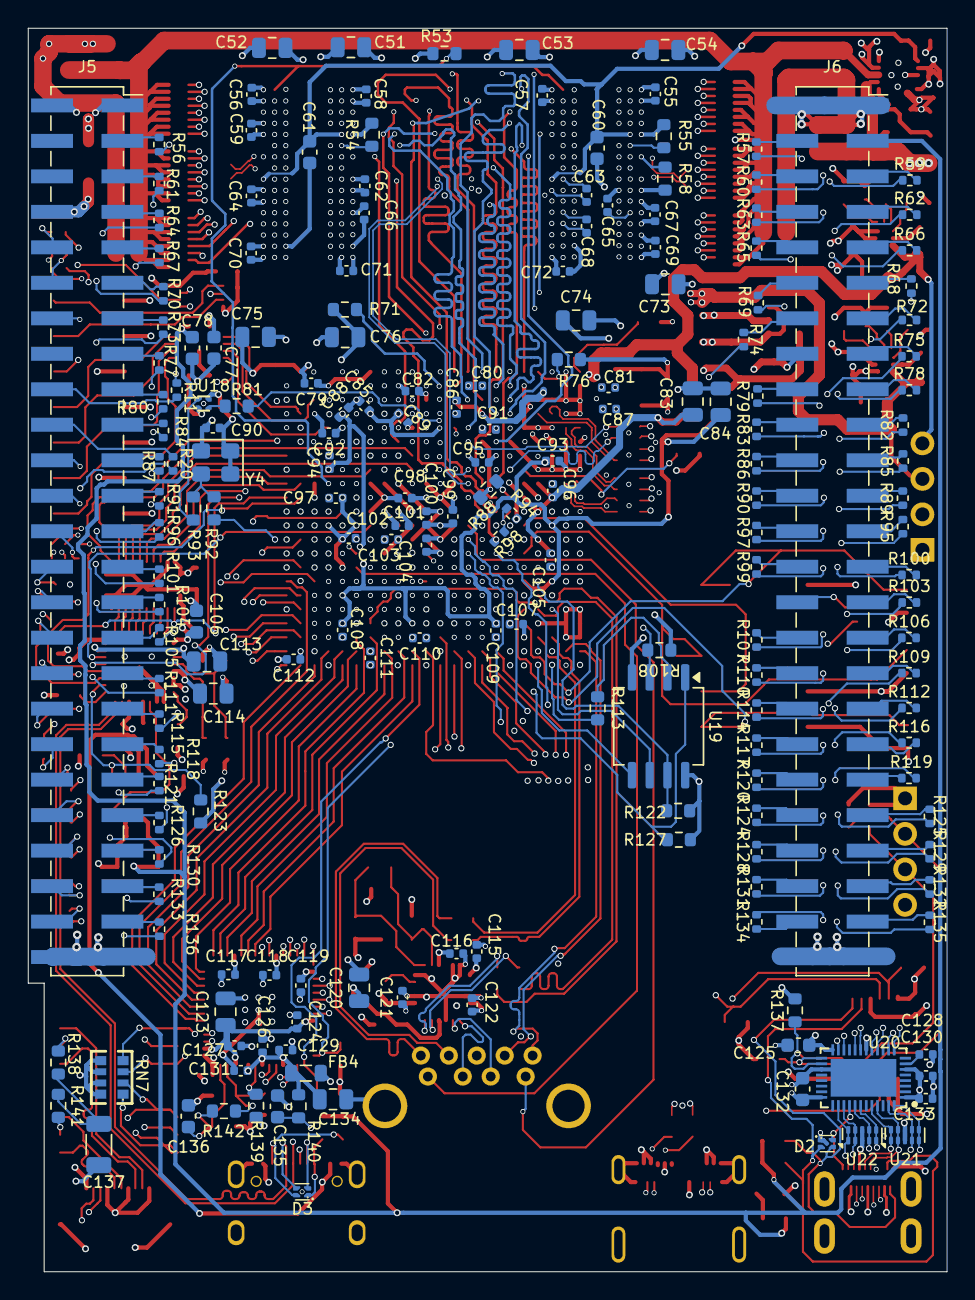
[picture p16: board mega_videl.kicad_pcb from below]

Board: 10 copper layers, 65.8 x 89.0 mm, 333 parts (190 on the bottom side), 450 nets.
