scrameta/mega_videl/(commit log)

2026-09-21 First cut without errors. Needs schematic and board checking prior to prototype production
    [PCIe.kicad_sch, ddr3.kicad_sch, ddr3power.kicad_sch, ethernet.kicad_sch, expansion.kicad_sch, fpga.kicad_sch, mega_videl.kicad_pcb, mega_videl.kicad_sch]
2026-09-23 Made board narrower so it fits next to CT60 SDRAM. Moved JTAG over slightly - more height
    [ethernet.kicad_sch, mega_videl.kicad_pcb]
2026-09-26 Reviewed and fixed many issues. e.g. missing decoupling for 1.35v under fpga
    [PCIe.kicad_sch, ddr3.kicad_sch, ddr3power.kicad_sch, ethernet.kicad_sch, expansion.kicad_sch, fpga.kicad_sch, mega_videl.kicad_pcb, power.kicad_sch]
2026-09-26 Cut the bom lines slightly
    [bom.csv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]
2026-09-26 Refreshed gerbers/bom/pos file after line merge
    [bom.csv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]
2026-09-26 Assigned all parts with JLCPCB plugin
    [BOM-mega_videl.csv, PCIe.kicad_sch, bom.csv, ddr3.kicad_sch, ddr3power.kicad_sch, ethernet.kicad_sch, expansion.kicad_sch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]
2026-09-27 Added series resistors to all CT lines. They ring up to 7V apparently according to Super Videl devs. Some of that is likely the length of scope lines. The safety fix here is to add small 33ohm resist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
    [BOM-mega_videl.csv, PCIe.kicad_sch, ddr3.kicad_sch, ethernet.kicad_sch, expansion.kicad_sch, fpga.kicad_sch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]
2026-10-03 Use the jlcpcb plugin output directly
    [BOM-mega_videl.csv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]
2026-10-16 Minor silkscreen fixes
2026-10-16 Fix silkscreen issues. Fix DDRSINGLE trace width on inner layers. Added impedance control excel file for JLCPCB.
2026-10-24 Added note on other traces
